arsenal007/ADX/PCB/LCSDR.ods

Sheet: Sheet1
Id | Designator | Package | Quantity | Designation | Supplier and ref
1 | C82,C14,C20,C72,C74,C76,C78,C80,C84,C2,C3,C6,C16,C18,C22,C24,C26,C38,C45,C47,C50,C53,C55,C61,C73,C134,C89,C91,C108,C116,C117,C123,C124,C129,C130,C132,C104,C115,C125,C131,C92,C133 | C_1206_0603 | 42 | 100n
2 | R4,R1 | R_1206_0603 | 2 | k75
3 | U8,U1 | SOIC-14_3.9x8.7mm_Pitch1.27mm | 2 | MC33179DR2G
4 | C60,C69 | C_0603 | 2 | 390p
5 | L13,L12 | Resistor_Horizontal_RM10mm | 2 | 472K
6 | C57,C58,C63,C66,C68,C70,C8,C9 | TantalC_SizeA_EIA-3216_Wave | 8 | 6.8uF
7 | C10,C5,L17,L19 | C_0603 | 4 | 4.7uF
8 | C11,C34,C56,C65 | C_0603 | 4 | 15n
9 | C21,C86,C87,L23,L24,L25 | C_1206_0603 | 6 | 1uF
10 | C23,C33,C43,C51 | C_1206_0603 | 4 | 27n
11 | C25 | C_1206_0603 | 1 | 22p
12 | C44 | C_1206_0603 | 1 | 2n2
13 | C71,C90,C95,C96,C98,C99 | C_1206_0603 | 6 | 1n
14 | C77,C85,C83 | C_Radial_D5_L11_P2.5 | 3 | 100uF
15 | L11,L3,L2,L5 | Resistor_Horizontal_RM10mm | 4 | 100uH
16 | R3,R44,R9,R14,R22,R41,R52,R59,R60,R61,R62,R63,R64 | R_1206_0603 | 13 | 10k
17 | R5,R13,R25,R34,R40,R42,R43,R46,R47,R48 | R_0603 | 10 | 4k75
18 | R8,R29,R7,R26,R39,R45 | R_0603 | 6 | 1k 1%
19 | R11,R21,R31,R2 | R_0603 | 4 | 3k 1%
20 | R15,R16 | R_1206_0603 | 2 | k51
21 | R17,R36,R24,R33 | R_1206_0603 | 4 | 20R
22 | R19,R20,R53,R54 | R_1206_0603 | 4 | 2k2
23 | R28 | R_0603 | 1 | k560
24 | R30,R10 | R_0603 | 2 | k27
25 | R32,R18 | R_0603 | 2 | 1k5
26 | R37,R38,R49,R51 | R_1206_0603 | 4 | 1k
27 | R50 | R_1206_0603 | 1 | k15
28 | U2,U9,U3,U6 | TSSOP-16_4.4x5mm_Pitch0.65mm | 4 | 74HC4053
29 | U13 | SOT-223 | 1 | LD1117S33TR
30 | U14 | SOT-223 | 1 | LD1117S25CTR
31 | U4,U5 | SOT-23-6 | 2 | SN74LVC1G3157
32 | U11 | Si570 | 1 | Si570
33 | C19,C30,C41,C48,C13 | TantalC_SizeA_EIA-3216_Wave | 5 | 10uF 16v
34 | J1,J2,J3,J4 | audio_jack_3_5mm_PJ307 | 4 | JACK_TRS_3pins
35 | C27,C28 | C_0603 | 2 | 15pF
36 | C31,C32 | C_1206_0603 | 2 | 3n3
37 | C35,C37 | C_0603 | 2 | 120pF
38 | C36 | C_1206_0603 | 1 | 220pF
39 | C40 | C_1206_0603 | 1 | 22n
40 | C42 | C_0603 | 1 | 220p
41 | C59,C64 | C_1206_0603 | 2 | 10n
42 | L6,L7,L8 | C_0603 | 3 | 4,7uH
43 | Q1 | SOT-23 | 1 | BC850
44 | R6,R12 | R_1206_0603 | 2 | k10
45 | R23 | R_1206_0603 | 1 | 1M5
46 | R27 | R_0603 | 1 | k43
47 | R55 | R_1206_0603 | 1 | k18
48 | U7 | DHVQFN14 | 1 | 74LVC74ABQ
49 | U10 | XQFN8 | 1 | 74LVC1G74GM
50 | CON1 | BARREL_JACK | 1 | BARREL_JACK
51 | R35 | R_1206_0603 | 1 | 27R
52 | U16 | SO-16-W | 1 | PCF8574
53 | L1,L4,L9,L10 | Resistor_Horizontal_RM10mm | 4 | 47uH
54 | U12 | TO-252-2Lead | 1 | L78M09
55 | P8 | Pin_Header_Straight_1x03 | 1 | TX_PA
56 | C94 | C_0603 | 1 | 200p
57 | C97 | C_0603 | 1 | 750p
58 | C100 | C_0603 | 1 | 750pF
59 | C101,C102,C109,C110 | C_0603 | 4 | 220n
60 | C103,C105,C107 | C_0603 | 3 | 680p
61 | C106,C112,C113,C67 | C_0603 | 4 | 820p
62 | C111,C120,C122 | C_0603 | 3 | 360p
63 | C114,C119,C121 | C_1206_0603 | 3 | 33p
64 | C118 | C_1206_0603 | 1 | 180p
65 | C126 | C_0603 | 1 | 120p
66 | C127,C128 | C_1206_0603 | 2 | 270p
67 | D1,D2,D3,D4,D5,D6,D7,D8,D9,D10 | MiniMELF_Standard | 10 | BAV203-G08
68 | L16 | C_0603 | 1 | 10uF
69 | L18 | C_0603 | 1 | 4.7uH
70 | L20,L21,L22 | C_1206_0603 | 3 | 2.2uF
71 | L26,L27,L28 | C_0603 | 3 | 470nF
72 | L29,L30 | C_0603 | 2 | 220nF
73 | P2 | Pin_Header_Straight_1x03 | 1 | ANT/PA
74 | R56,R57 | R_1206_0603 | 2 | k47
75 | U15 | TO-92_Inline_Narrow_Oval | 1 | 78L05
76 | U17 | SOIC-16_3.9x9.9mm_Pitch1.27mm | 1 | ULN2003_
77 | L14,L15 | Resistor_Horizontal_RM10mm | 2 | 47uF
78 | R58 | R_1206_0603 | 1 | 0*
79 | P1 | Pin_Header_Straight_1x04 | 1 | I2C_Si570
80 | U18 | XQFN8 | 1 | PCA9306
81 | P3,P4,P5 | Pin_Header_Straight_1x02 | 3 | CONN_01X02
82 | C75 | C_Radial_D10_L13_P5 | 1 | 820uF
83 | O1,O2,O3,O4 | MountingHole_3.2mm_M3_Pad_Via | 4 | Mount_Hole
84 | C12,C29,C39,C62 | TantalC_SizeA_EIA-3216_Wave | 4 | 10uF
85 | C49,C52,C54,C88,C93,C7,C17,C79,C81,C4,C15,C1 | Universal_C_Radial_D5_L11_P2_tantal | 12 | 10uF
86 | C46 | Universal_C_Radial_D5_L11_P2_tantal | 1 | 10uF

Sheet: Assembly
Stage1
 | C74 | 1206 | 100n
 | CON1 | 2.1mm
 | C75 | 5mm(TH) D10 | 820uF
 | U12 | D2PAK | L78M09
 | C76 | 1206 | 100n
 | C77 | 2,5mm(TH) D10 | 100uF
 | C78 | 1206 | 100n
 | C79 |  | 10uF
 | C80 | 1206 | 100n
 | C81 |  | 10uF
 | U13 | 223 | LD1117S33TR
 | C82 | 1206 | 100n
 | C83 | 2,5mm(TH) D10 | 100uF
 | U14 | 223 | LD1117S25TR
 | R55 | 1206 | k180
 | C84 | 1206 | 100n
 | U15 | TO-92 | 78L05
 | C85 | 2,5mm(TH) D10 | 100uF
 | C88 | 2mm (TH) D10 | 10uF
 | C91 | 1206 | 100n
 | C92 | 1206 | 100n
 | C93 | 2mm (TH) D10 | 10uF
Check voltages output on U12/U13/U14
Stage2(Schifting voltages and Inductors)
 | R15 | 1206 | k51
 | R16 | 1206 | k51
 | C13 | Tantal. SizeA | 10uf
 | C14 | 1206 | 100n
 | L4 | 10mm TH | 47uH
 | C21 | 1206 | 100n
 | C22 | 1206 | 1uF
 | L9 | 10mm TH | 47uH
 | C45 | 1206 | 100n
 | C47 | 1206 | 100n
 | C46 | 2mm (TH) D10 | 10uF
 | R49 | 1206 | 1k
 | R51 | 1206 | 1k
 | R50 | 1206 | k15
 | C72 | 1206 | 100n
 | C71 | 1206 | 1n
 | C73 | 1206 | 100n
 | L3 | 10mm TH | 100uH
 | C15 | 2mm (TH) D10 | 10uF
 | C17 | 2mm (TH) D10 | 10uF
 | C16 | 1206 | 100n
 | C18 | 1206 | 100n
 | C134 | 1206 | 100n
 | L1 | 10mm TH | 47uH
 | C3 | 1206 | 100n
 | C4 | 2mm (TH) D10 | 10uF
 | L10 | 10mm TH | 47uH
 | C52 | 2,5mm(TH) D10 | 10uF
 | C53 | 1206 | 100n
 | C62 | Tantal. SizeA | 10uF
 | C63 | 1206 | 100n
 | R1 | 1206 | k750
 | R4 | 1206 | k750
 | C7 | 2mm (TH) D10 | 10uF
 | C6 | 1206 | 100n
 | L11 | 10mm TH | 100uH
 | L2 | 10mm TH | 100uH
 | C1 | 2mm (TH) D10 | 10uF
 | C2 | 1206 | 100n
 | C54 | 2mm (TH) D10 | 10uF
 | C55 | 1206 | 100n
 | R27 | 0603 | k43
 | R28 | 0603 | k56
 | C38 | 1206 | 100n
 | C39 | 2mm (TH) D10 | 1206
 | R37 | 1206 | 1k
 | R38 | 1206 | 1k
 | C49 | 2mm (TH) D10 | 10uF
 | C50 | 1206 | 100n
 | C12 | 2mm (TH) D10 | 10uF
 | C20 | 1206 | 100n
 | C133 | 1206 | 100n
 | L14 | 10mm TH | 47uH
 | L15 | 10mm TH | 47uH
 | R56 | 1206 | k47
 | R57 | 1206 | k47
 | D1 |  | BAV203-g08
 | D2 |  | BAV203-g08
 | L17 | 0603 | 4.7uH
 | L18 | 0603 | 4.7uH
 | C101 | 0603 | 220n
 | C102 | 0603 | 220n
 | R59 | 1206 | 10k
 | D3 |  | BAV203-g08
 | D4 |  | BAV203-g08
 | L21 | 1206 | 2.2uH
 | L20 | 1206 | 2.2uH
 | R60 | 1206 | 10k
 | С110 | 0603 | 220n
 | C109 | 0603 | 220n
 | D5 |  | BAV203-g08
 | D6 |  | BAV203-g08
 | L23 | 1206 | 1uH
 | L24 | 1206 | 1uH
 | R61 | 1206 | 10k
 | C116 | 1206 | 100n
 | C117 | 1206 | 100n
 | D7 |  | BAV203-g08
 | D8 |  | BAV203-g08
 | L26 | 0603 | 470nH
 | L27 | 0603 | 470nH
 | C123 | 1206 | 100n
 | C124 | 1206 | 100n
 | R62 | 1206 | 10k
 | D9 |  | BAV203-g08
 | D10 |  | BAV203-g08
 | C129 | 1206 | 100n
 | C130 | 1206 | 100n
 | L29 | 0603 | 220nH
 | L30 | 0603 | 220nH
 | R63 | 1206 | 10k
 | C89 | 1206 | 100n
 | C108 | 1206 | 100n
 | C115 | 1206 | 100n
 | C125 | 1206 | 100n
 | C131 | 1206 | 100n
Test all voltages on U4/U5/U3/U6/U1/U8/U10/U7/U11/U16/U18/U9/U2/R27_R28(MIC_AMP)/R37_R38(LIN input schift)/R1_R4(OA_AMP_BASIS)/R49_R51_Si570_schift
Stage3 (digital testing) | U11 |  | Si570
 | U16 |  | PCF8574
 | U18 |  | PCA9306
 | R64 | 1206 | 10k
 | R52 | 1206 | 10k
 | R53 | 1206 | 2k2
 | R54 | 1206 | 2k2
 | U17 | SO-16 | ULN2003
 | C65 | 0603 | 15n
 | C11 | 0603 | 15n
