arsenal007/ADX/PCBs_OpA/LCSDR.kicad_pcb

## KiCad design PCBs_OpA/LCSDR.kicad_pcb (2023-01-05)

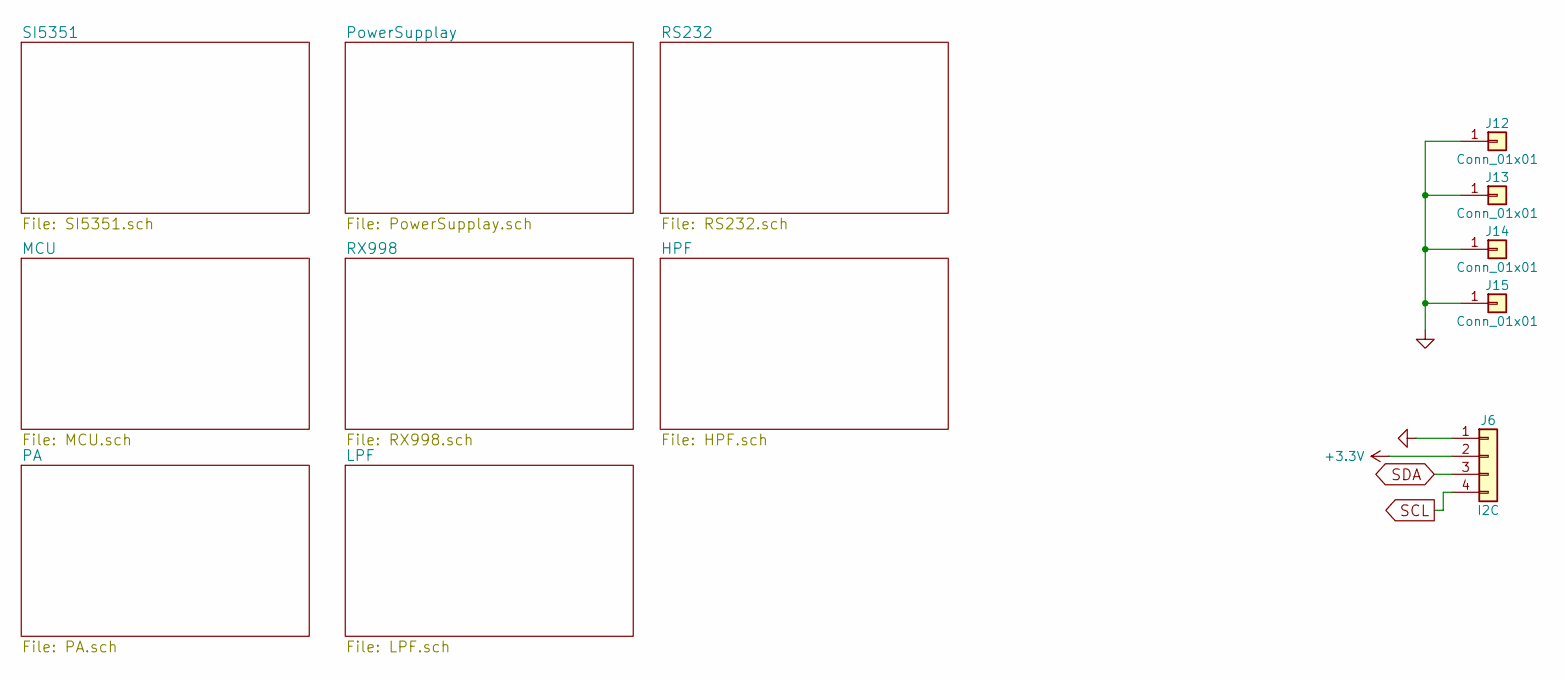
[picture p1: schematic LCSDR.sch, ADX988]

Parts:
J6: I2C; Pin_Header_Straight_1x04_Pitch2.54mm
J12, J13, J14, J15: Conn_01x01; MountingHole_3.2mm_M3_DIN965_Pad

Connections:
+3V3: J6.2; also elsewhere on the board
GND: J6.1, J12.1, J13.1, J14.1, J15.1; also elsewhere on the board
SCL: J6.4; also elsewhere on the board
SDA: J6.3; also elsewhere on the board

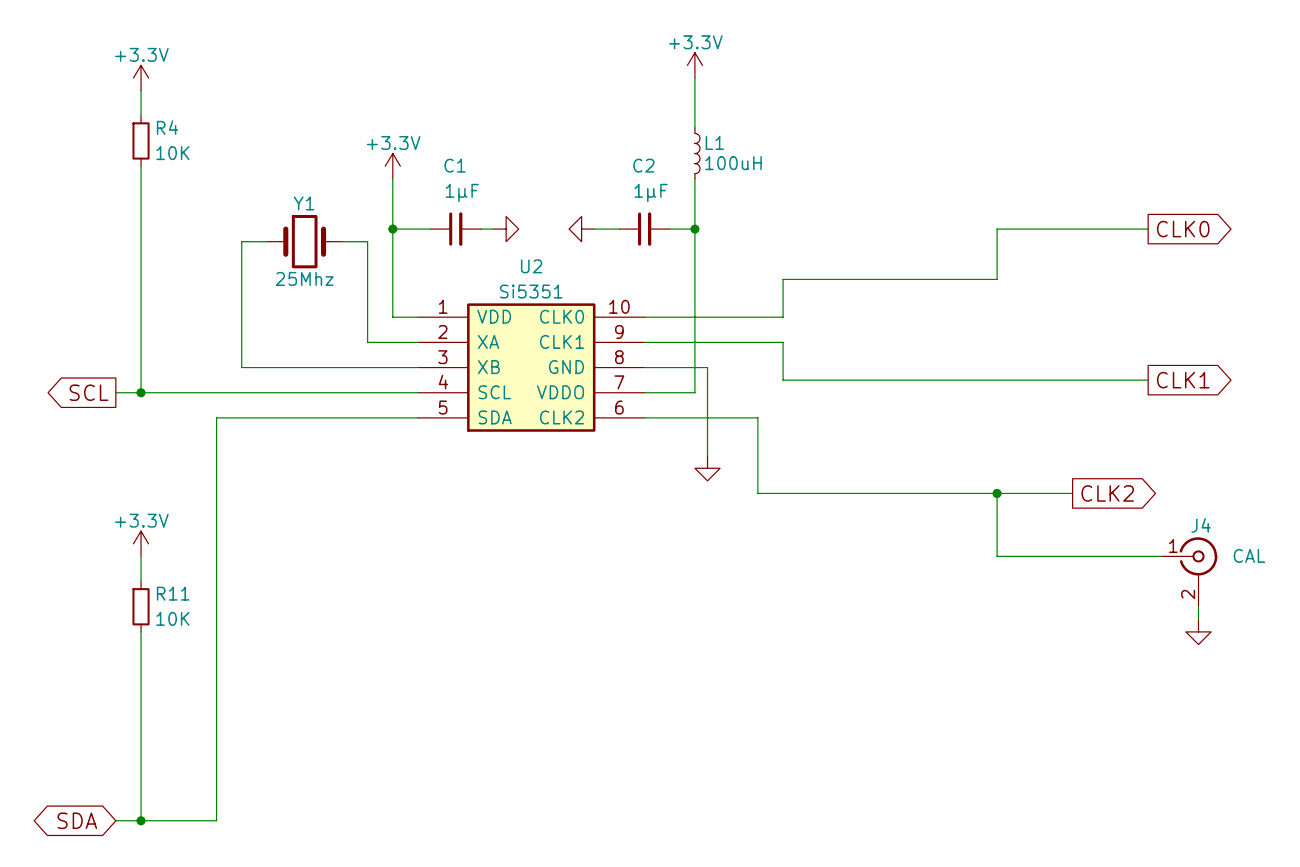
[picture p2: schematic SI5351.sch]

Parts:
C1, C2: 1µF; C_1206_0603
J4: CAL; U.FL_Molex_MCRF_73412-0110_Vertical
L1: 100uH; R_Axial_DIN0207_L6.3mm_D2.5mm_P10.16mm_Horizontal
R4, R11: 10K; R_1206_0603
U2: Si5351; MSOP-10_3x3mm_Pitch0.5mm
Y1: 25Mhz; Crystal_SMD_HC49-SD

Connections:
+3V3: C1.1, L1.1, R4.1, R11.1, U2.1 (VDD); also elsewhere on the board
CLK0: U2.10 (CLK0); also elsewhere on the board
CLK1: U2.9 (CLK1); also elsewhere on the board
CLK2: J4.1 (In), U2.6 (CLK2); also elsewhere on the board
GND: C1.2, C2.1, J4.2 (Ext), U2.8 (GND); also elsewhere on the board
unnamed: C2.2, L1.2, U2.7 (VDDO)
unnamed: U2.2 (XA), Y1.2
unnamed: U2.3 (XB), Y1.1
SCL: R4.2, U2.4 (SCL); also elsewhere on the board
SDA: R11.2, U2.5 (SDA); also elsewhere on the board

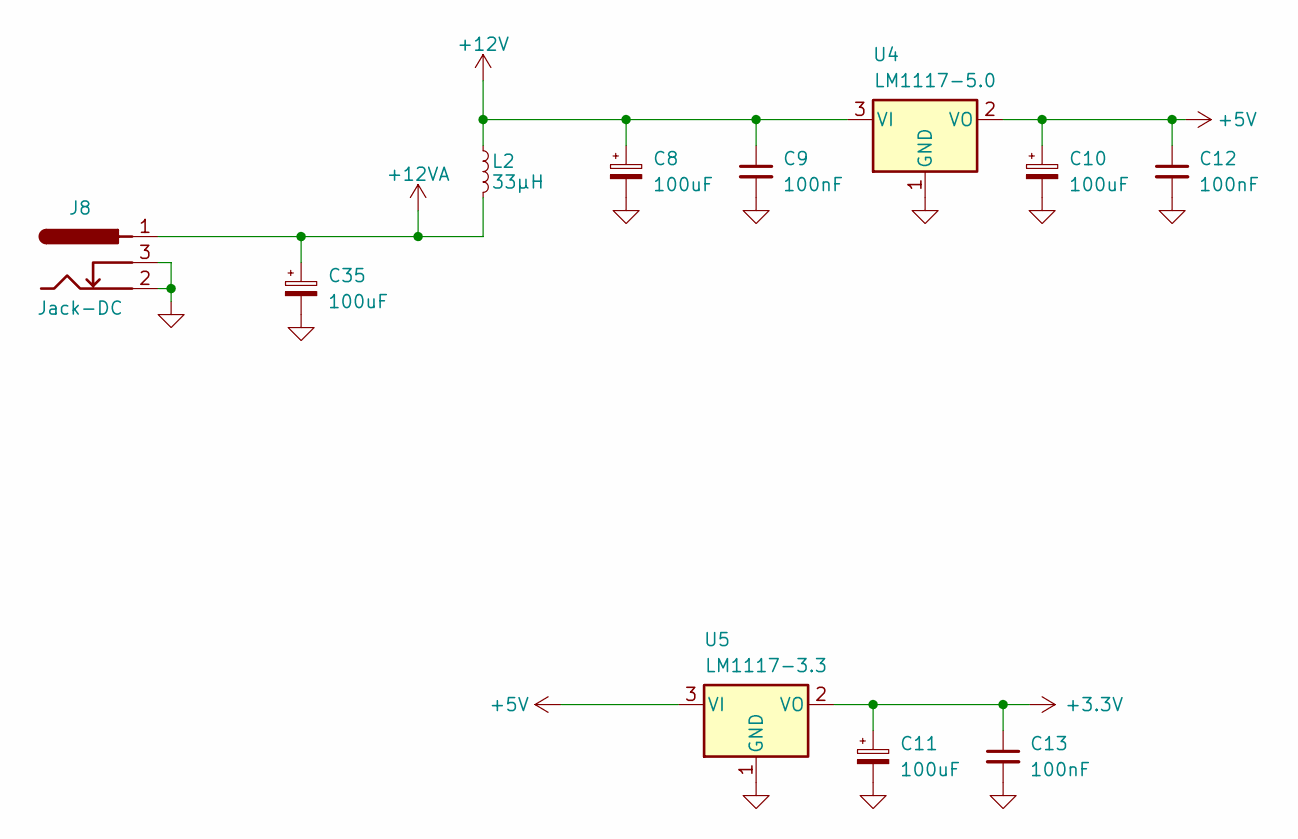
[picture p3: schematic PowerSupplay.sch]

Parts:
C8, C10, C11, C35: 100uF; CP_Radial_D6.3mm_P2.50mm
C9, C12, C13: 100nF; C_1206_0603
J8: Jack-DC; BARREL_JACK
L2: 33µH; Choke_Horizontal_RM10mm
U4: LM1117-5.0; SOT-223-3_TabPin2
U5: LM1117-3.3; SOT-223-3_TabPin2

Connections:
+3V3: C11.1, C13.1, U5.2 (VO); also elsewhere on the board
+5V: C10.1, C12.1, U4.2 (VO), U5.3 (VI); also elsewhere on the board
+12V: C8.1, C9.1, L2.1, U4.3 (VI); also elsewhere on the board
+12VA: C35.1, J8.1, L2.2; also elsewhere on the board
GND: C8.2, C9.2, C10.2, C11.2, C12.2, C13.2, C35.2, J8.2, J8.3, U4.1 (GND), U5.1 (GND); also elsewhere on the board

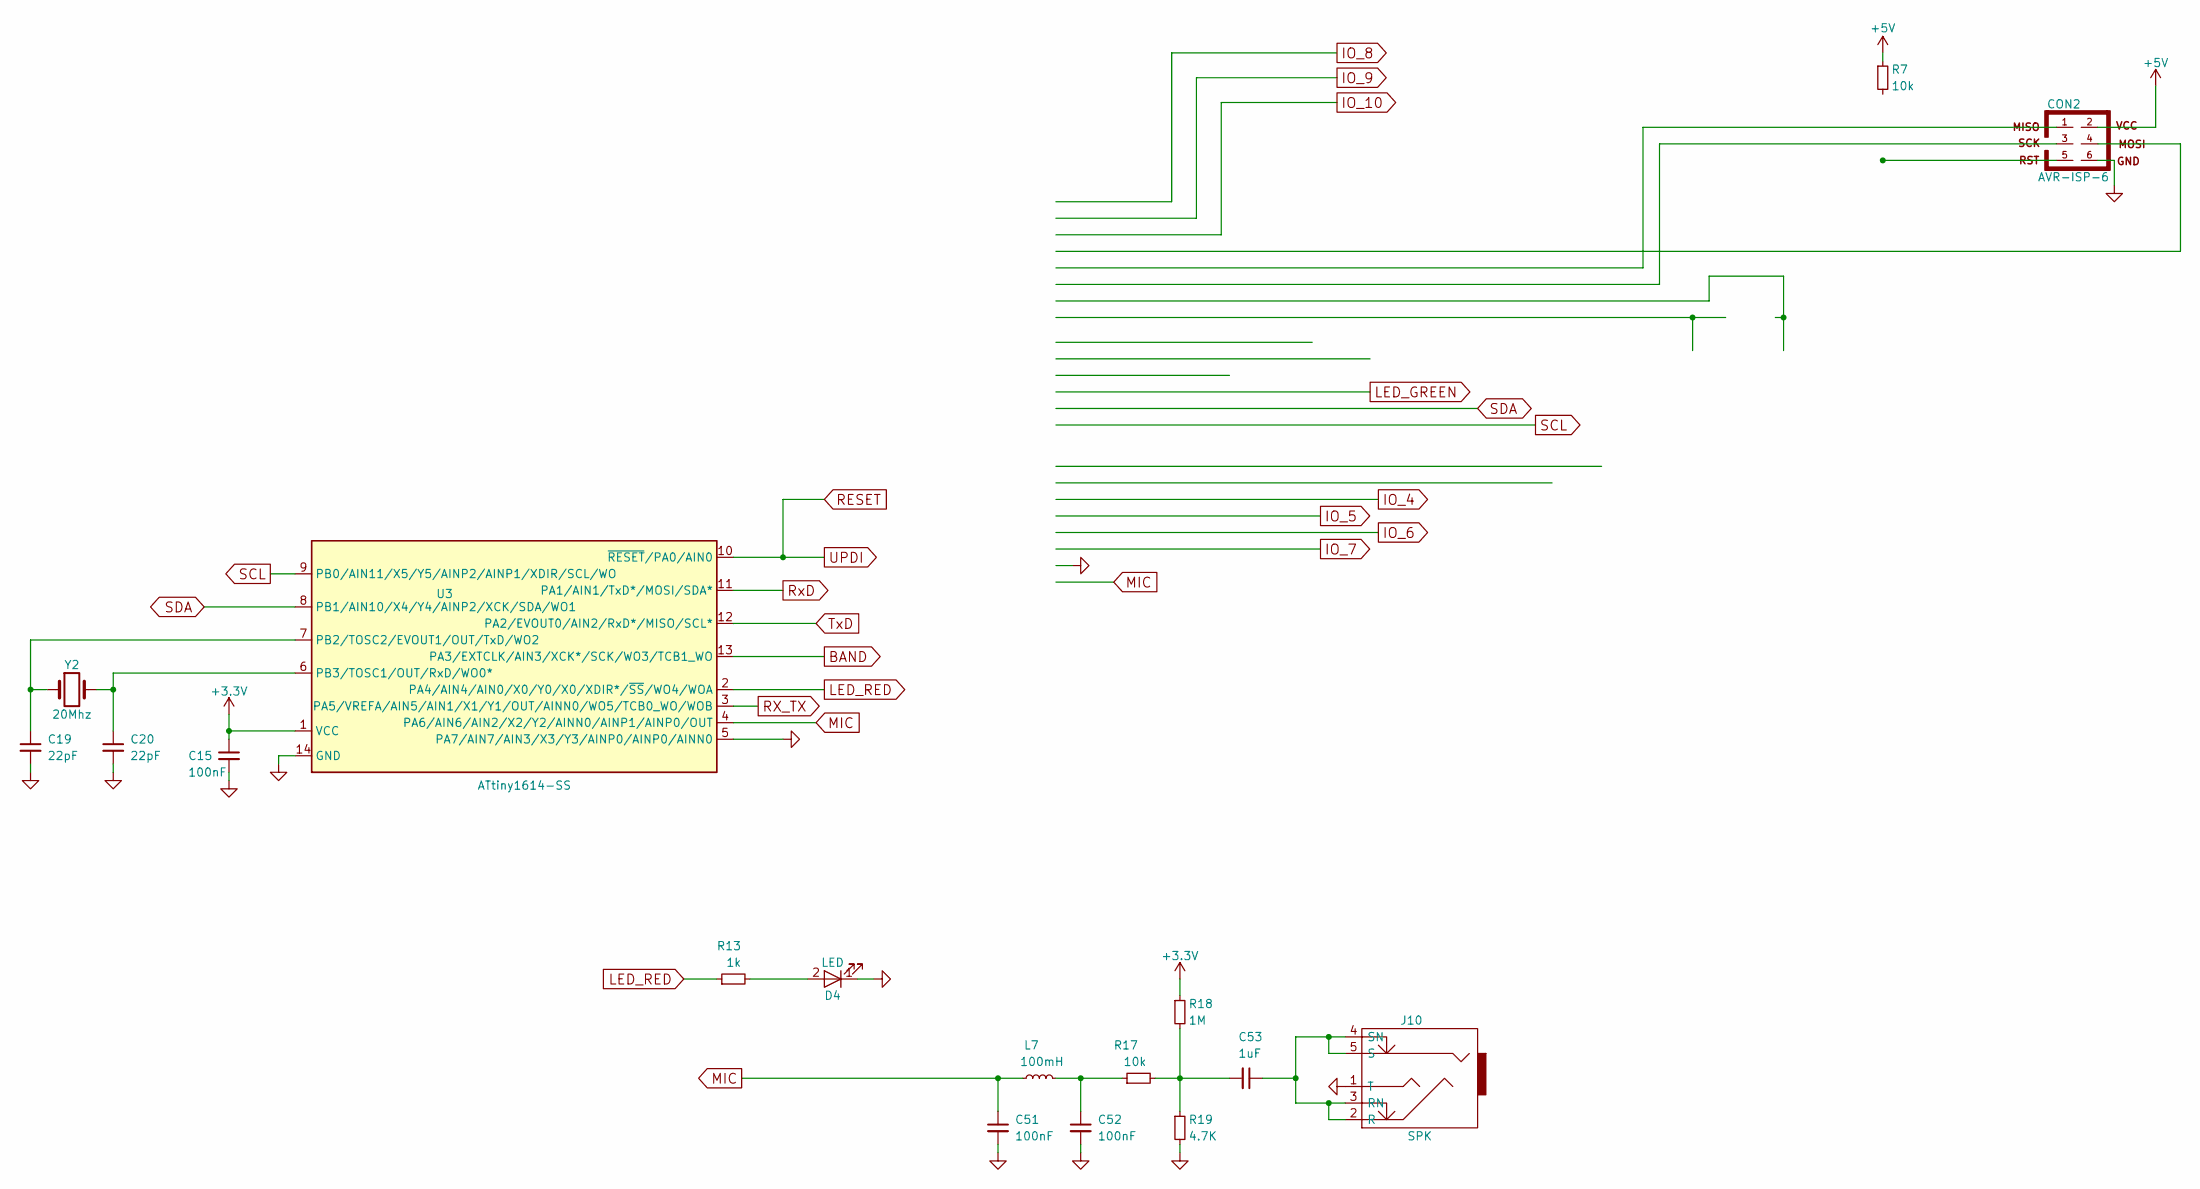
[picture p4: schematic MCU.sch]

Parts:
C15, C51, C52: 100nF; C_1206_0603
C19, C20: 22pF; C_1206_0603
C53: 1uF; C_1206_0603
CON2: AVR-ISP-6; IDC-Header_2x03_Pitch2.54mm_Straight
D4: LED; LED_D3.0mm_Horizontal_O3.81mm_Z10.0mm
J10: SPK; audio_jack_3_5mm_PJ307
L7: 100mH; Choke_Toroid_8x16mm_Vertical
R7, R17: 10k; R_1206_0603
R13: 1k; R_1206_0603
R18: 1M; R_1206_0603
R19: 4.7K; R_1206_0603
U3: ATtiny1614-SS; SOIC-14_3.9x8.7mm_Pitch1.27mm
Y2: 20Mhz; Crystal_HC49-U_Vertical

Connections:
+3V3: C15.1, R18.1, U3.1 (VCC); also elsewhere on the board
+5V: CON2.2, R7.1; also elsewhere on the board
GND: C15.2, C19.2, C20.2, C51.2, C52.2, CON2.6, D4.1 (K), J10.1 (T), R19.2, U3.5 (PA7/AIN7/AIN3/X3/Y3/AINP0/AINP0/AINN0), U3.14 (GND); also elsewhere on the board
LED_RED: R13.1, U3.2 (PA4/AIN4/AIN0/X0/Y0/X0/XDIR*/~SS~/WO4/W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)
MIC: C51.1, L7.1, U3.4 (PA6/AIN6/AIN2/X2/Y2/AINN0/AINP1/AINP0/O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)
unnamed: C19.1, U3.7 (PB2/TOSC2/EVOUT1/OUT/TxD/WO2), Y2.1
unnamed: C20.1, U3.6 (PB3/TOSC1/OUT/RxD/WO0*), Y2.2
unnamed: C52.1, L7.2, R17.1
unnamed: C53.1, J10.2 (R), J10.3 (RN), J10.4 (SN), J10.5 (S)
unnamed: C53.2, R17.2, R18.2, R19.1
unnamed: D4.2 (A), R13.2
RESET: U3.10 (~RESET~/PA0/AIN0); also elsewhere on the board
RX_TX: U3.3 (PA5/VREFA/AIN5/AIN1/X1/Y1/OUT/AINN0/WO5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); also elsewhere on the board
RxD: U3.11 (PA1/AIN1/TxD*/MOSI/SDA*); also elsewhere on the board
SCL: U3.9 (PB0/AIN11/X5/Y5/AINP2/AINP1/XDIR/SCL/WO); also elsewhere on the board
SDA: U3.8 (PB1/AIN10/X4/Y4/AINP2/XCK/SDA/WO1); also elsewhere on the board
TxD: U3.12 (PA2/EVOUT0/AIN2/RxD*/MISO/SCL*); also elsewhere on the board

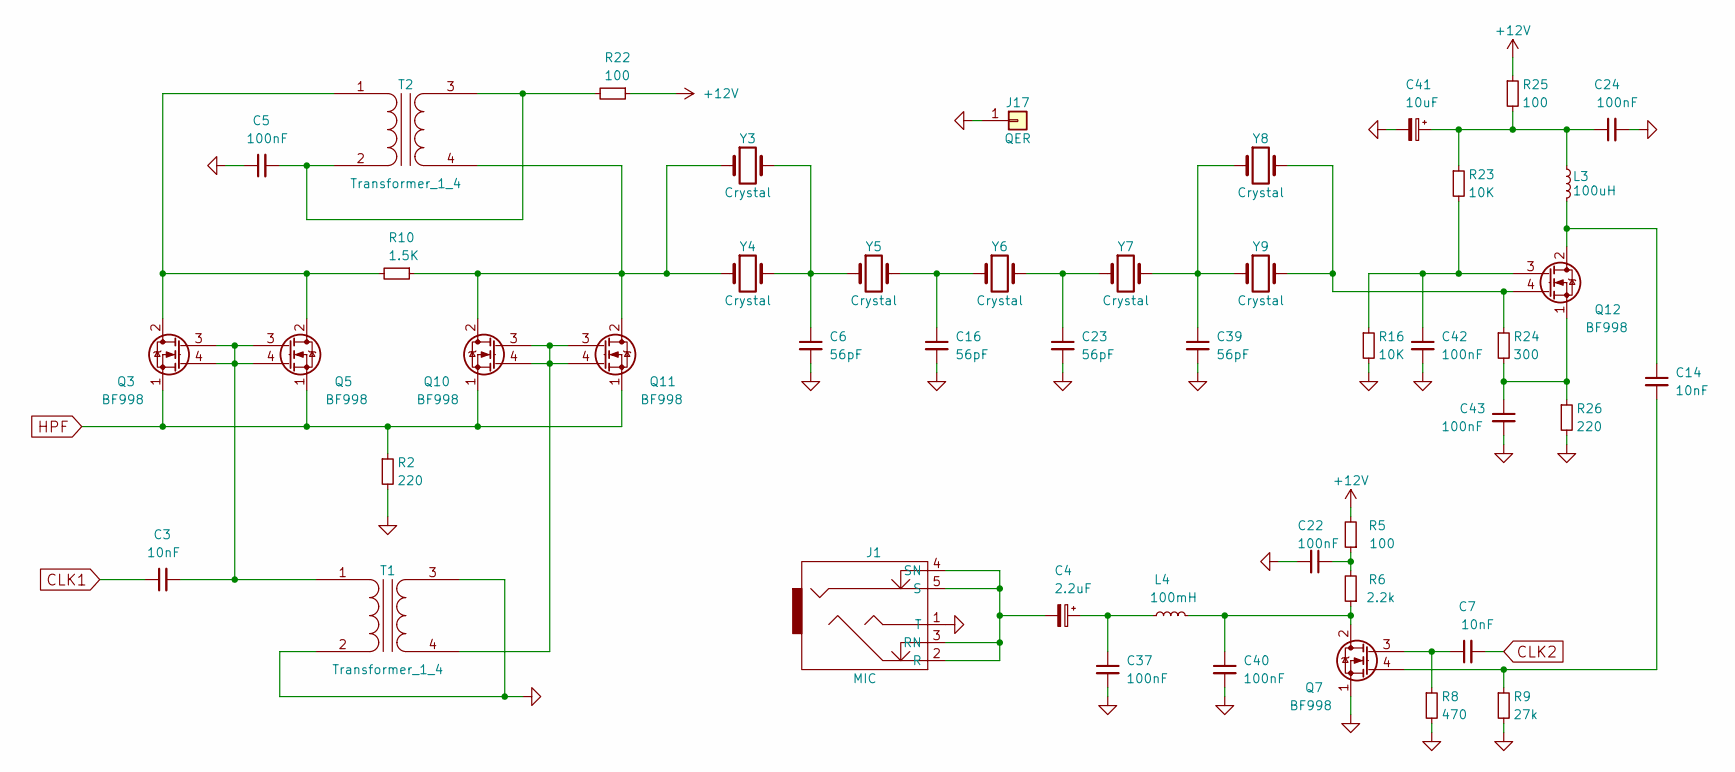
[picture p5: schematic RX998.sch]

Parts:
C3, C7, C14: 10nF; C_1206_0603
C4: 2.2uF; CP_Radial_D5.0mm_P2.00mm
C5, C22, C24, C37, C40, C42, C43: 100nF; C_1206_0603
C6, C16, C23, C39: 56pF; C_1206_0603
C41: 10uF; CP_Radial_D5.0mm_P2.00mm
J1: MIC; audio_jack_3_5mm_PJ307
J17: QER; Pin_Header_Straight_1x01_Pitch2.54mm
L3: 100uH; Choke_Horizontal_RM10mm
L4: 100mH; Choke_Toroid_8x16mm_Vertical
Q3, Q5, Q7, Q10, Q11, Q12: BF998; SOT-143
R2, R26: 220; R_1206_0603
R5, R22, R25: 100; R_1206_0603
R6: 2.2k; R_1206_0603
R8: 470; R_1206_0603
R9: 27k; R_1206_0603
R10: 1.5K; R_1206_0603
R16, R23: 10K; R_1206_0603
R24: 300; R_1206_0603
T1, T2: Transformer_1_4; TF14
Y3, Y4, Y5, Y6, Y7, Y8, Y9: Crystal; Crystal_HC49-U_Vertical

Connections:
+12V: R5.2, R22.1, R25.1; also elsewhere on the board
CLK1: C3.1; also elsewhere on the board
CLK2: C7.2; also elsewhere on the board
GND: C5.1, C6.2, C16.2, C22.2, C23.2, C24.2, C37.2, C39.2, C40.2, C41.2, C42.2, C43.2, J1.1 (T), J17.1, Q7.1 (S), R2.2, R8.2, R9.2, R16.2, R26.2, T1.2 (AB), T1.3; also elsewhere on the board
HPF: Q3.1 (S), Q5.1 (S), Q10.1 (S), Q11.1 (S), R2.1; also elsewhere on the board
unnamed: C3.2, Q3.3 (G2), Q3.4 (G1), Q5.3 (G2), Q5.4 (G1), T1.1 (AA)
unnamed: C4.2, J1.2 (R), J1.3 (RN), J1.4 (SN), J1.5 (S)
unnamed: C5.2, R22.2, T2.2 (AB), T2.3
unnamed: C6.1, Y3.2, Y4.2, Y5.1
unnamed: C7.1, Q7.3 (G2), R8.1
unnamed: C14.1, L3.2, Q12.2 (D)
unnamed: C14.2, Q7.4 (G1), R9.1
unnamed: C16.1, Y5.2, Y6.1
unnamed: C22.1, R5.1, R6.2
unnamed: C23.1, Y6.2, Y7.1
unnamed: C24.1, C41.1, L3.1, R23.1, R25.2
unnamed: C4.1, C37.1, L4.1
unnamed: C39.1, Y7.2, Y8.1, Y9.1
unnamed: C40.1, L4.2, Q7.2 (D), R6.1
unnamed: C42.1, Q12.3 (G2), R16.1, R23.2
unnamed: C43.1, Q12.1 (S), R24.2, R26.1
unnamed: Q3.2 (D), Q5.2 (D), R10.2, T2.1 (AA)
unnamed: Q10.2 (D), Q11.2 (D), R10.1, T2.4, Y3.1, Y4.1
unnamed: Q10.3 (G2), Q10.4 (G1), Q11.3 (G2), Q11.4 (G1), T1.4
unnamed: Q12.4 (G1), R24.1, Y8.2, Y9.2

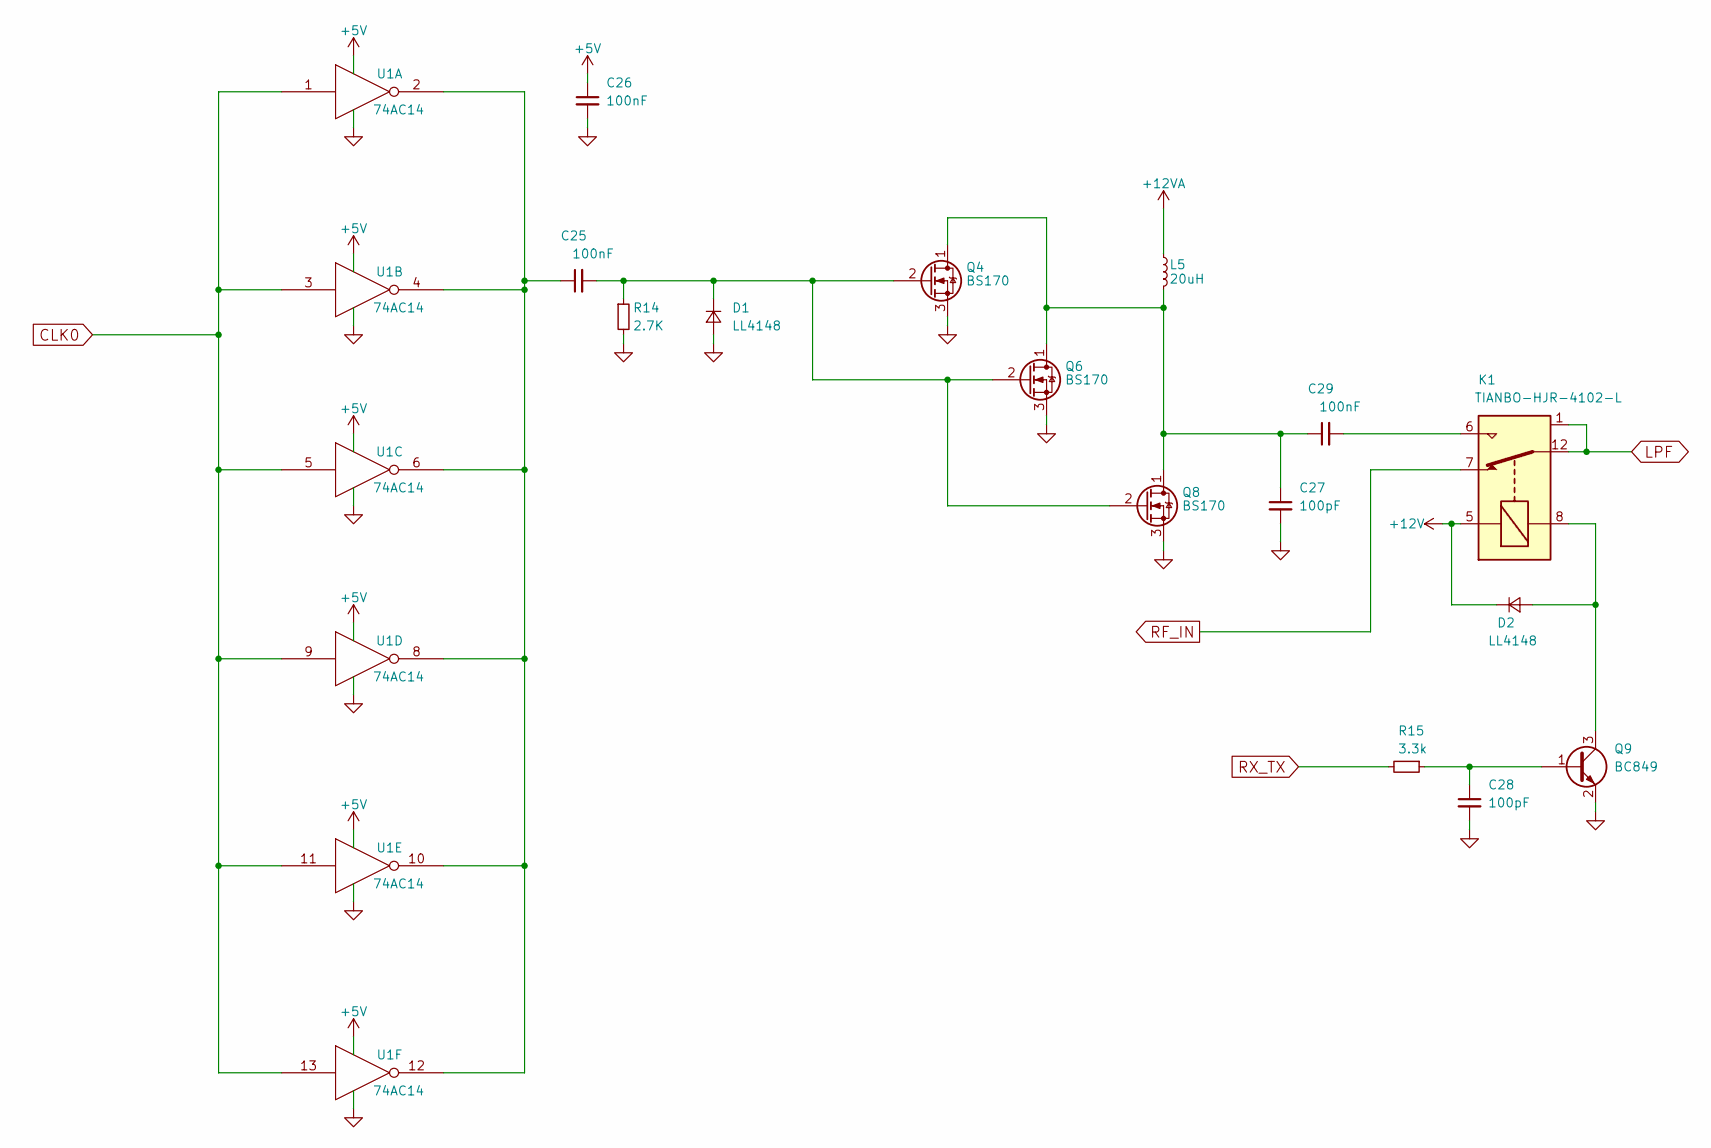
[picture p6: schematic PA.sch]

Parts:
C25, C26, C29: 100nF; C_1206_0603
C27: 100pF; C_Disc_D4.7mm_W2.5mm_P5.00mm
C28: 100pF; C_1206_0603
D1, D2: LL4148; D_MiniMELF
K1: TIANBO-HJR-4102-L; Relay_SPDT_HJR-4102
L5: 20uH; Choke_Toroid_6,5x13mm_Vertical
Q4, Q6, Q8: BS170; TO-92_Inline_Wide
Q9: BC849; SOT-23
R14: 2.7K; R_1206_0603
R15: 3.3k; R_1206_0603
U1: 74AC14; DIP-14_W7.62mm_LongPads

Connections:
+5V: C26.1, U1.14 (VCC); also elsewhere on the board
+12V: D2.1 (K), K1.5; also elsewhere on the board
+12VA: L5.1; also elsewhere on the board
CLK0: U1.1, U1.3, U1.5, U1.9, U1.11, U1.13; also elsewhere on the board
GND: C26.2, C27.2, C28.2, D1.2 (A), Q4.3 (S), Q6.3 (S), Q8.3 (S), Q9.2 (E), R14.2, U1.7 (GND); also elsewhere on the board
LPF: K1.1, K1.12; also elsewhere on the board
unnamed: C25.1, U1.2, U1.4, U1.6, U1.8, U1.10, U1.12
unnamed: C25.2, D1.1 (K), Q4.2 (G), Q6.2 (G), Q8.2 (G), R14.1
unnamed: C27.1, C29.1, L5.2, Q4.1 (D), Q6.1 (D), Q8.1 (D)
unnamed: C28.1, Q9.1 (B), R15.1
unnamed: C29.2, K1.6
unnamed: D2.2 (A), K1.8, Q9.3 (C)
RF_IN: K1.7; also elsewhere on the board
RX_TX: R15.2; also elsewhere on the board

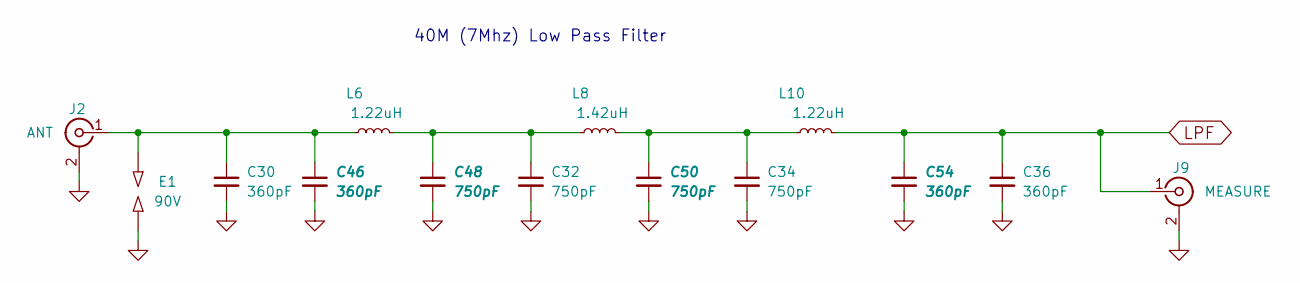
[picture p7: schematic LPF.sch]

Parts:
C30, C36: 360pF; C_Disc_D4.7mm_W2.5mm_P5.00mm
C32, C34: 750pF; C_Disc_D4.7mm_W2.5mm_P5.00mm
C46, C54: 360pF; C_1206_0603
C48, C50: 750pF; C_1206_0603
E1: 90V; C_Rect_L11.0mm_W8.8mm_P10.00mm_MKT
J2: ANT; SMA_THT_Jack_Straight
J9: MEASURE; U.FL_Molex_MCRF_73412-0110_Vertical
L6, L10: 1.22uH; Choke_Toroid_6,5x13mm_Vertical
L8: 1.42uH; Choke_Toroid_6,5x13mm_Vertical

Connections:
GND: C30.2, C32.2, C34.2, C36.2, C46.2, C48.2, C50.2, C54.2, E1.2, J2.2 (Ext), J9.2 (Ext); also elsewhere on the board
LPF: C36.1, C54.1, J9.1 (In), L10.2; also elsewhere on the board
unnamed: C30.1, C46.1, E1.1, J2.1 (In), L6.1
unnamed: C32.1, C48.1, L6.2, L8.1
unnamed: C34.1, C50.1, L8.2, L10.1

Notes on the sheet:
40M (7Mhz) Low Pass Filter

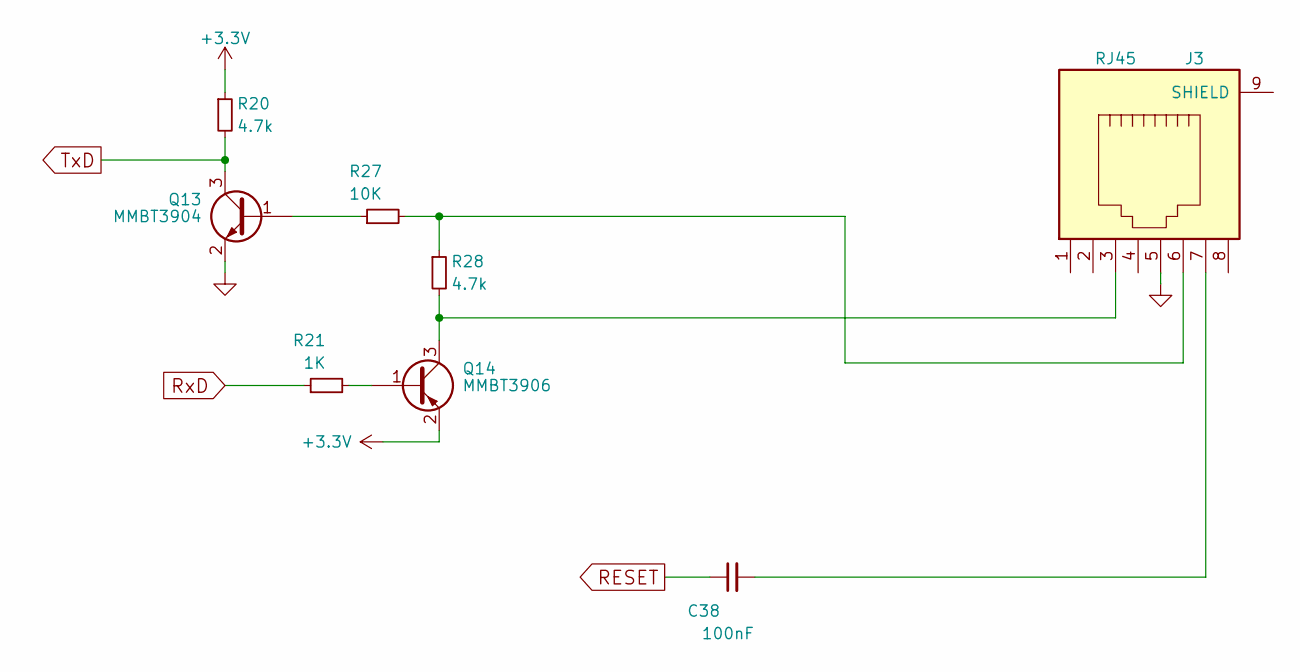
[picture p8: schematic RS232.sch]

Parts:
C38: 100nF; C_1206_0603
J3: RJ45; RJ45_8
Q13: MMBT3904; SOT-23
Q14: MMBT3906; SOT-23
R20, R28: 4.7k; R_0603_HandSoldering
R21: 1K; R_0603_HandSoldering
R27: 10K; R_0603_HandSoldering

Connections:
+3V3: Q14.2 (E), R20.1; also elsewhere on the board
GND: J3.5, Q13.2 (E); also elsewhere on the board
unnamed: C38.2, J3.7
unnamed: J3.3, Q14.3 (C), R28.2
unnamed: J3.6, R27.2, R28.1
unnamed: Q13.1 (B), R27.1
unnamed: Q14.1 (B), R21.2
RESET: C38.1; also elsewhere on the board
RxD: R21.1; also elsewhere on the board
TxD: Q13.3 (C), R20.2; also elsewhere on the board

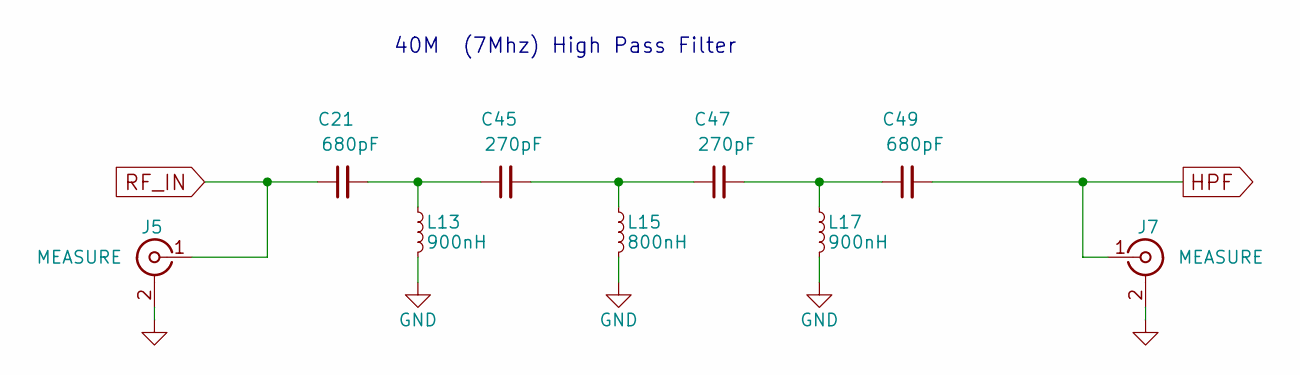
[picture p9: schematic HPF.sch]

Parts:
C21, C49: 680pF; C_1206_0603
C45, C47: 270pF; C_1206_0603
J5, J7: MEASURE; U.FL_Molex_MCRF_73412-0110_Vertical
L13, L17: 900nH; Choke_Toroid_6,5x13mm_Vertical
L15: 800nH; Choke_Toroid_6,5x13mm_Vertical

Connections:
GND: J5.2 (Ext), J7.2 (Ext), L13.2, L15.2, L17.2; also elsewhere on the board
HPF: C49.2, J7.1 (In); also elsewhere on the board
unnamed: C21.2, C45.1, L13.1
unnamed: C45.2, C47.1, L15.1
unnamed: C47.2, C49.1, L17.1
RF_IN: C21.1, J5.1 (In); also elsewhere on the board

Notes on the sheet:
40M (7Mhz) High Pass Filter

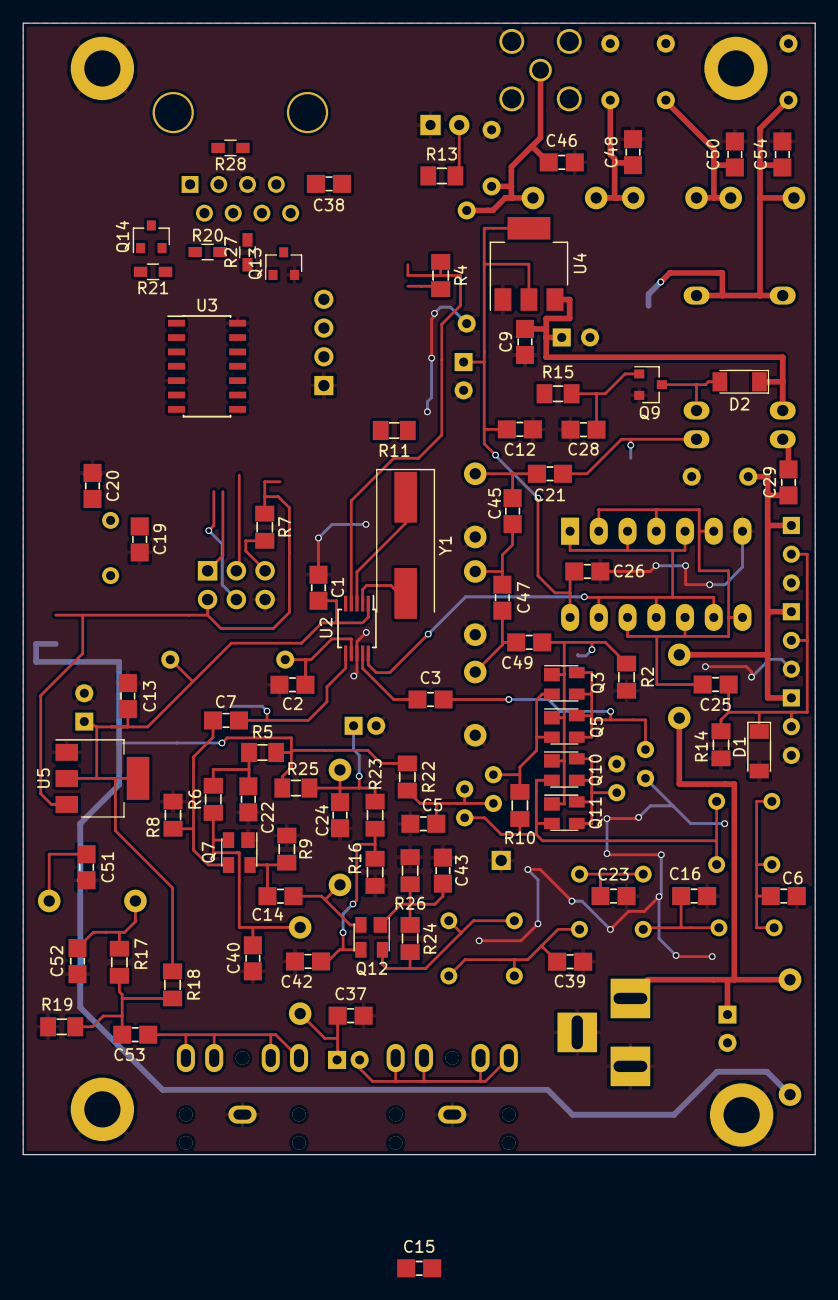
[picture p10: board PCBs_OpA/LCSDR.kicad_pcb from above]

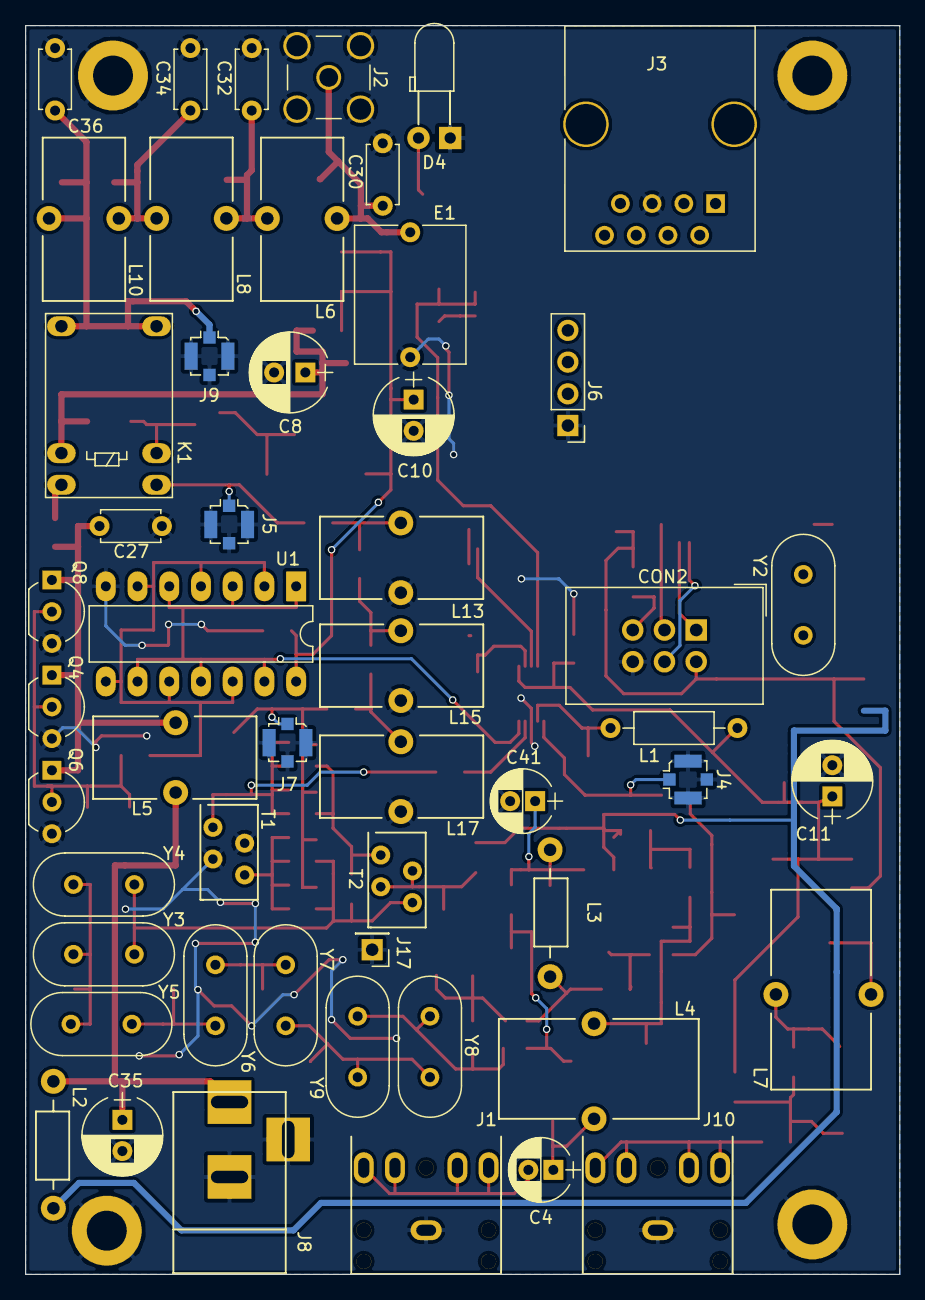
[picture p11: board PCBs_OpA/LCSDR.kicad_pcb from below]

Board: 2 copper layers, 70.0 x 100.0 mm, 135 parts (52 on the bottom side), 65 nets.
