arsenal007/ADX/PCBs/LCSDR.kicad_pcb

## KiCad design PCBs/LCSDR.kicad_pcb (2023-01-05)

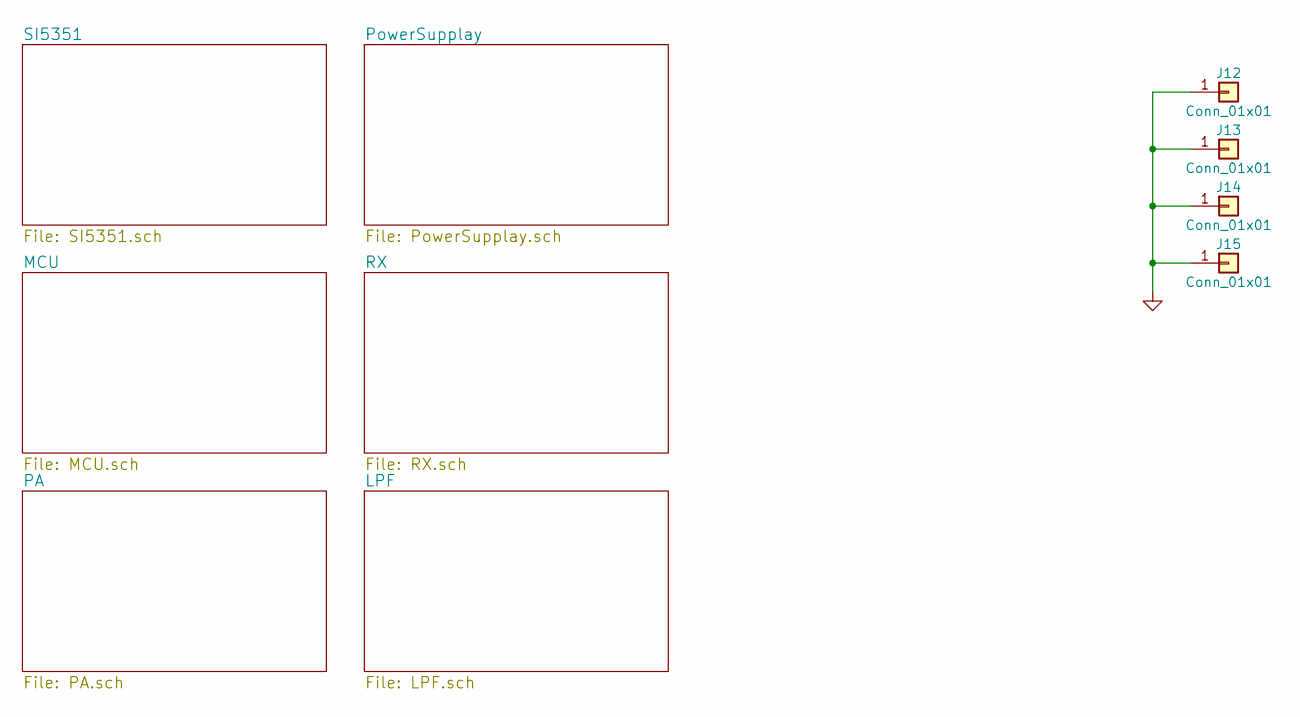
[picture p12: schematic LCSDR.sch, UT3MK VFO]

Parts:
J12, J13, J14, J15: Conn_01x01; MountingHole_3.2mm_M3_DIN965_Pad

Connections:
GND: J12.1, J13.1, J14.1, J15.1; also elsewhere on the board

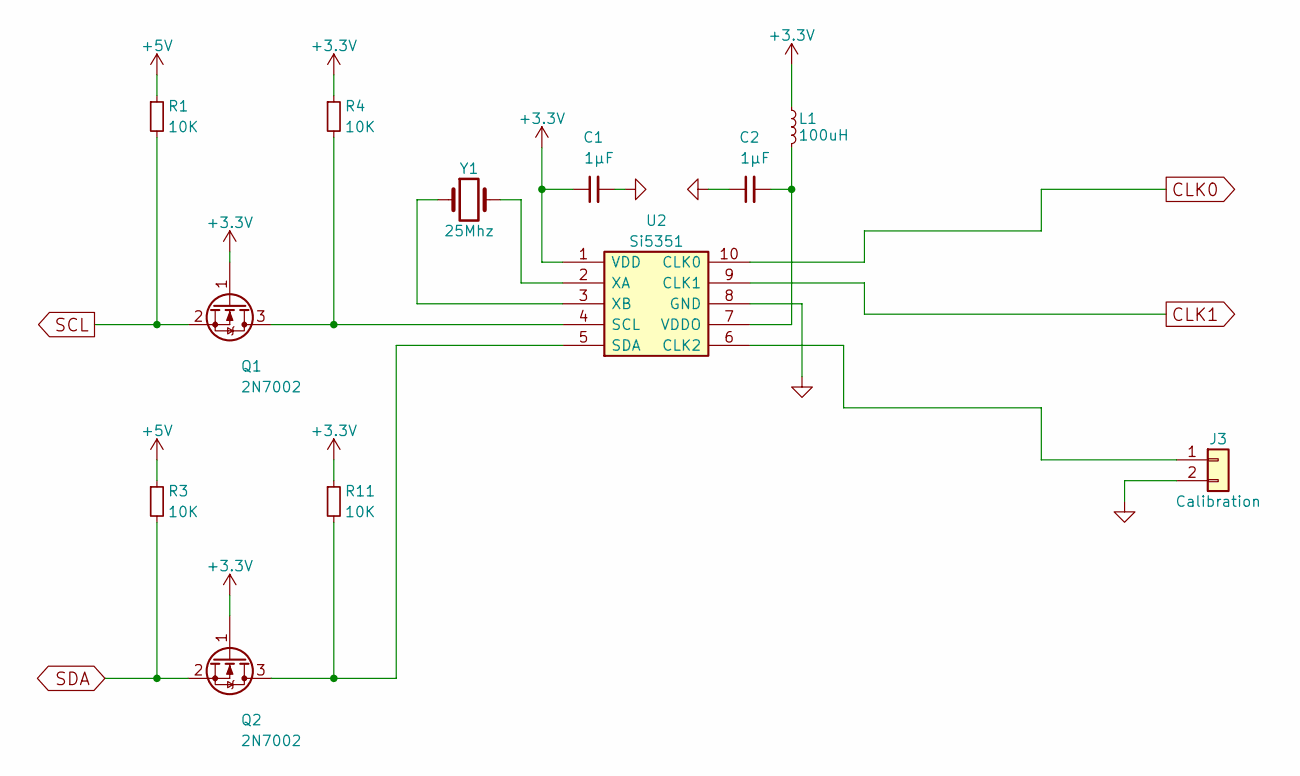
[picture p13: schematic SI5351.sch]

Parts:
C1, C2: 1µF; C_1206_0603
J3: Calibration; Pin_Header_Straight_1x02_Pitch2.54mm
L1: 100uH; Choke_Horizontal_RM10mm
Q1, Q2: 2N7002; SOT-23
R1, R3, R4, R11: 10K; R_0603_HandSoldering
U2: Si5351; MSOP-10_3x3mm_Pitch0.5mm
Y1: 25Mhz; Crystal_HC49-U_Vertical

Connections:
+3V3: C1.1, L1.1, Q1.1 (G), Q2.1 (G), R4.1, R11.1, U2.1 (VDD); also elsewhere on the board
+5V: R1.1, R3.1; also elsewhere on the board
CLK0: U2.10 (CLK0); also elsewhere on the board
CLK1: U2.9 (CLK1); also elsewhere on the board
GND: C1.2, C2.1, J3.2, U2.8 (GND); also elsewhere on the board
unnamed: C2.2, L1.2, U2.7 (VDDO)
unnamed: J3.1, U2.6 (CLK2)
unnamed: Q1.3 (D), R4.2, U2.4 (SCL)
unnamed: Q2.3 (D), R11.2, U2.5 (SDA)
unnamed: U2.2 (XA), Y1.2
unnamed: U2.3 (XB), Y1.1
SCL: Q1.2 (S), R1.2; also elsewhere on the board
SDA: Q2.2 (S), R3.2; also elsewhere on the board

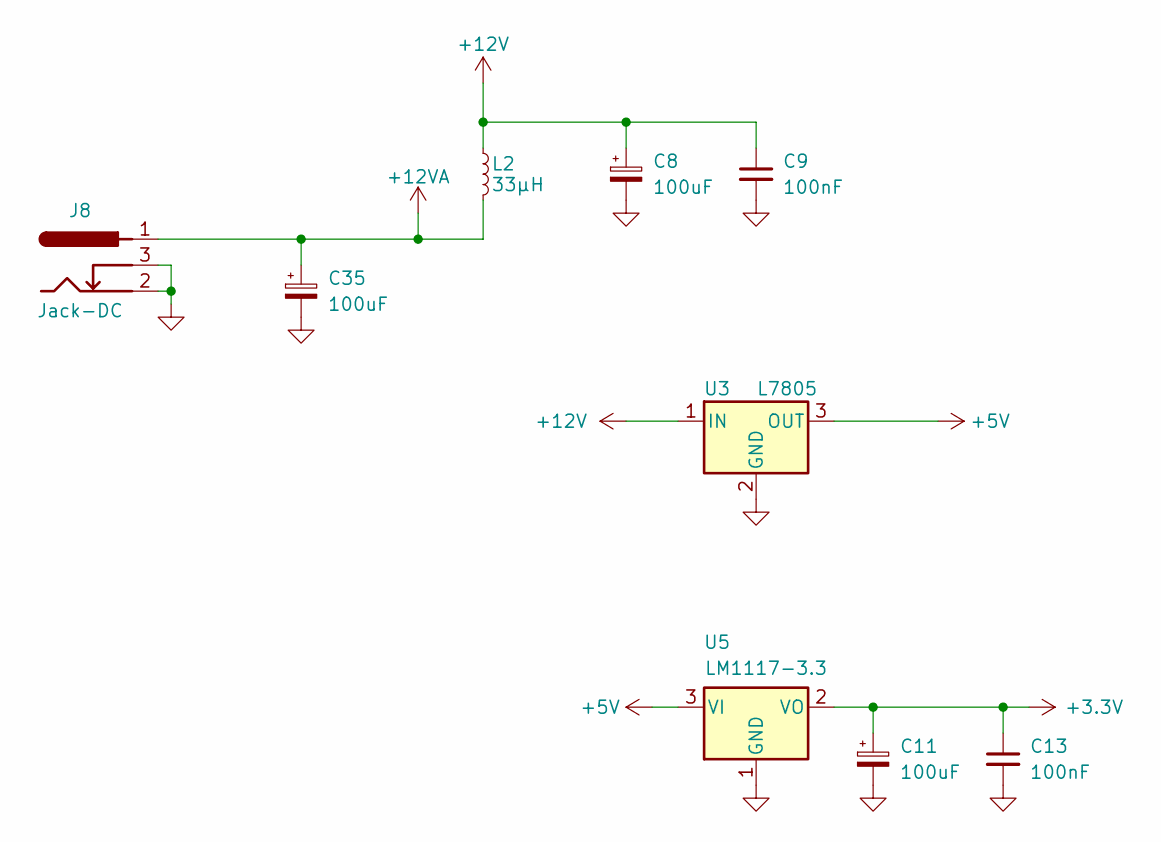
[picture p14: schematic PowerSupplay.sch]

Parts:
C8, C11, C35: 100uF; CP_Radial_D6.3mm_P2.50mm
C9, C13: 100nF; C_0603_HandSoldering
J8: Jack-DC; BARREL_JACK
L2: 33µH; Choke_Horizontal_RM10mm
U3: L7805; TO-220-3_Vertical
U5: LM1117-3.3; SOT-223-3_TabPin2

Connections:
+3V3: C11.1, C13.1, U5.2 (VO); also elsewhere on the board
+5V: U3.3 (OUT), U5.3 (VI); also elsewhere on the board
+12V: C8.1, C9.1, L2.1, U3.1 (IN); also elsewhere on the board
+12VA: C35.1, J8.1, L2.2; also elsewhere on the board
GND: C8.2, C9.2, C11.2, C13.2, C35.2, J8.2, J8.3, U3.2 (GND), U5.1 (GND); also elsewhere on the board
