arsenal007/ADX/PCBs/LCSDR.kicad_pcb

## KiCad design PCBs/LCSDR.kicad_pcb (continued)

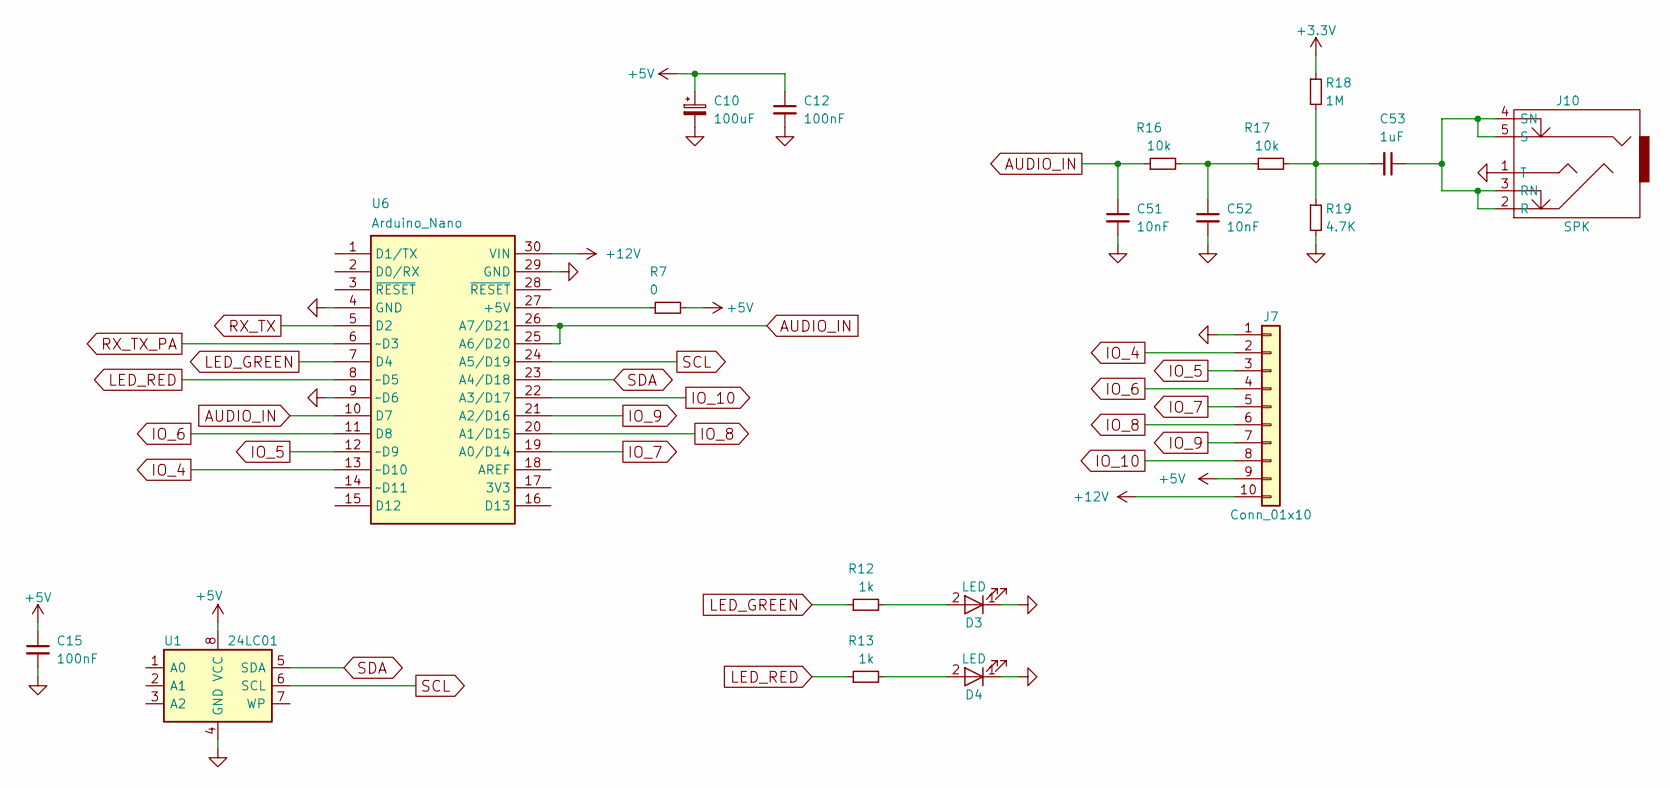
[picture p15: schematic MCU.sch]

Parts:
C10: 100uF; CP_Radial_D6.3mm_P2.50mm
C12, C15: 100nF; C_0603_HandSoldering
C51, C52: 10nF; C_0603_HandSoldering
C53: 1uF; C_0603_HandSoldering
D3, D4: LED; LED_0603_HandSoldering
J7: Conn_01x10; Pin_Header_Straight_1x10_Pitch2.54mm
J10: SPK; audio_jack_3_5mm_PJ307
R7: 0; R_0603_HandSoldering
R12, R13: 1k; R_0603_HandSoldering
R16, R17: 10k; R_0603_HandSoldering
R18: 1M; R_0603_HandSoldering
R19: 4.7K; R_0603_HandSoldering
U1: 24LC01; SOIC-8_3.9x4.9mm_Pitch1.27mm
U6: Arduino_Nano

Connections:
+3V3: R18.1; also elsewhere on the board
+5V: C10.1, C12.1, C15.1, J7.9, R7.2, U1.8 (VCC); also elsewhere on the board
+12V: J7.10, U6.30 (VIN); also elsewhere on the board
AUDIO_IN: C51.1, R16.1, U6.10 (D7), U6.25 (A6/D20), U6.26 (A7/D21)
GND: C10.2, C12.2, C15.2, C51.2, C52.2, D3.1 (K), D4.1 (K), J7.1, J10.1 (T), R19.2, U1.4 (GND), U6.4 (GND), U6.9 (~~D6), U6.29 (GND); also elsewhere on the board
IO_4: J7.2, U6.13 (~~D10)
IO_5: J7.3, U6.12 (~~D9)
IO_6: J7.4, U6.11 (D8)
IO_7: J7.5, U6.19 (A0/D14)
IO_8: J7.6, U6.20 (A1/D15)
IO_9: J7.7, U6.21 (A2/D16)
IO_10: J7.8, U6.22 (A3/D17)
LED_GREEN: R12.1, U6.7 (D4)
LED_RED: R13.1, U6.8 (~~D5)
unnamed: C52.1, R16.2, R17.1
unnamed: C53.1, J10.2 (R), J10.3 (RN), J10.4 (SN), J10.5 (S)
unnamed: C53.2, R17.2, R18.2, R19.1
unnamed: D3.2 (A), R12.2
unnamed: D4.2 (A), R13.2
unnamed: R7.1, U6.27 (+5V)
RX_TX: U6.5 (D2); also elsewhere on the board
RX_TX_PA: U6.6 (~~D3); also elsewhere on the board
SCL: U1.6 (SCL), U6.24 (A5/D19); also elsewhere on the board
SDA: U1.5 (SDA), U6.23 (A4/D18); also elsewhere on the board

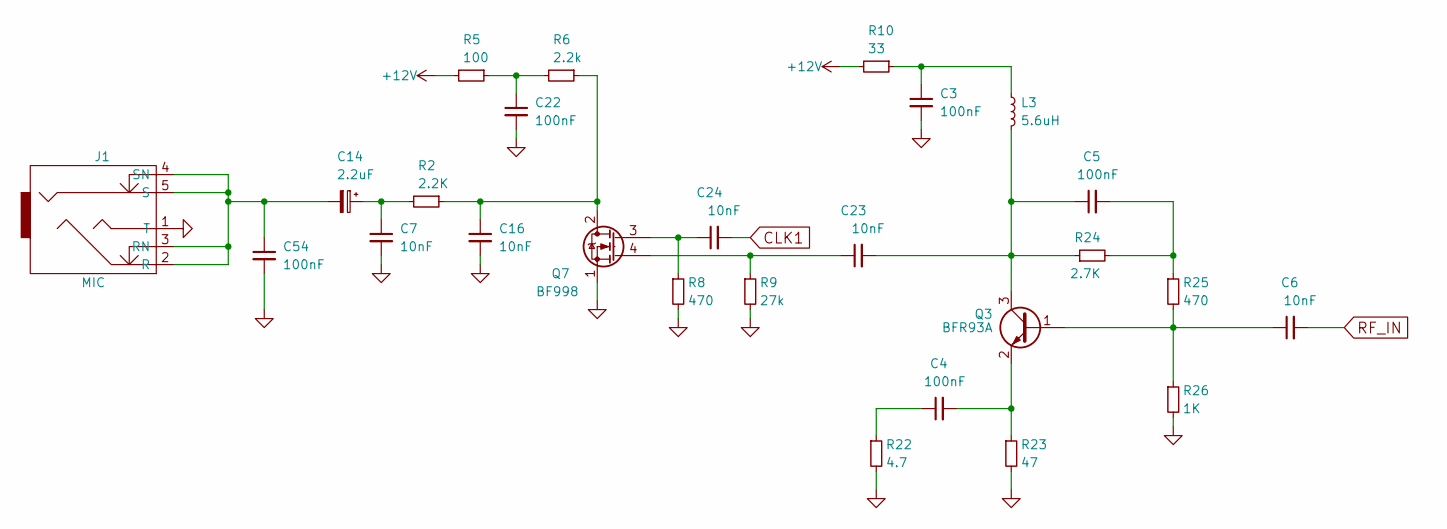
[picture p16: schematic RX.sch]

Parts:
C3, C4, C5, C22, C54: 100nF; C_0603_HandSoldering
C6, C7, C16, C23, C24: 10nF; C_0603_HandSoldering
C14: 2.2uF; CP_Radial_D5.0mm_P2.00mm
J1: MIC; audio_jack_3_5mm_PJ307
L3: 5.6uH; Choke_Horizontal_RM10mm
Q3: BFR93A; SOT-23
Q7: BF998; SOT-143
R2: 2.2K; R_1206_0603
R5: 100; R_1206_0603
R6: 2.2k; R_1206_0603
R8, R25: 470; R_1206_0603
R9: 27k; R_1206_0603
R10: 33; R_1206_0603
R22: 4.7; R_1206_0603
R23: 47; R_1206_0603
R24: 2.7K; R_1206_0603
R26: 1K; R_1206_0603

Connections:
+12V: R5.2, R10.2; also elsewhere on the board
CLK1: C24.2; also elsewhere on the board
GND: C3.2, C7.2, C16.2, C22.2, C54.2, J1.1 (T), Q7.1 (S), R8.2, R9.2, R22.2, R23.2, R26.2; also elsewhere on the board
unnamed: C3.1, L3.1, R10.1
unnamed: C4.1, R22.1
unnamed: C4.2, Q3.2 (E), R23.1
unnamed: C5.2, R24.2, R25.1
unnamed: C6.1, Q3.1 (B), R25.2, R26.1
unnamed: C7.1, C14.1, R2.2
unnamed: C14.2, C54.1, J1.2 (R), J1.3 (RN), J1.4 (SN), J1.5 (S)
unnamed: C16.1, Q7.2 (D), R2.1, R6.1
unnamed: C22.1, R5.1, R6.2
unnamed: C23.1, Q7.4 (G1), R9.1
unnamed: C5.1, C23.2, L3.2, Q3.3 (C), R24.1
unnamed: C24.1, Q7.3 (G2), R8.1
RF_IN: C6.2; also elsewhere on the board

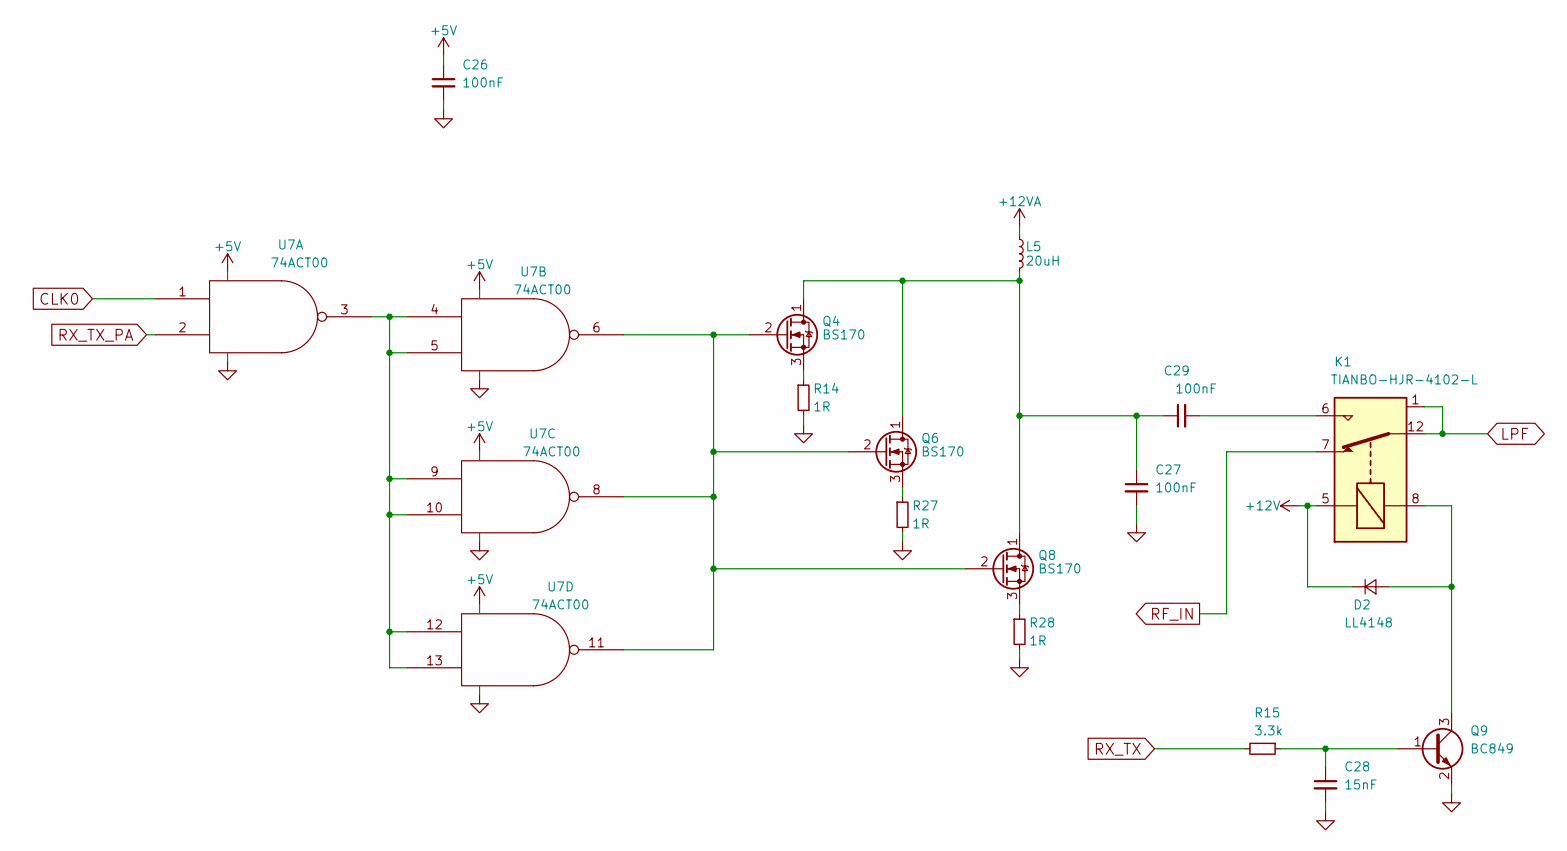
[picture p17: schematic PA.sch]

Parts:
C26, C27, C29: 100nF; C_0603_HandSoldering
C28: 15nF; C_0603_HandSoldering
D2: LL4148; D_MiniMELF
K1: TIANBO-HJR-4102-L; Relay_SPDT_HJR-4102
L5: 20uH; Choke_Toroid_6,5x13mm_Vertical
Q4, Q6, Q8: BS170; TO-92_Inline_Wide
Q9: BC849; SOT-23
R14, R27, R28: 1R; R_1206_0603
R15: 3.3k; R_0603_HandSoldering
U7: 74ACT00; SOIC-14_3.9x8.7mm_Pitch1.27mm

Connections:
+5V: C26.1, U7.14 (VCC); also elsewhere on the board
+12V: D2.1 (K), K1.5; also elsewhere on the board
+12VA: L5.1; also elsewhere on the board
CLK0: U7.1; also elsewhere on the board
GND: C26.2, C27.2, C28.2, Q9.2 (E), R14.2, R27.2, R28.2, U7.7 (GND); also elsewhere on the board
LPF: K1.1, K1.12; also elsewhere on the board
unnamed: C27.1, C29.1, L5.2, Q4.1 (D), Q6.1 (D), Q8.1 (D)
unnamed: C28.1, Q9.1 (B), R15.1
unnamed: C29.2, K1.6
unnamed: D2.2 (A), K1.8, Q9.3 (C)
unnamed: Q4.2 (G), Q6.2 (G), Q8.2 (G), U7.6, U7.8, U7.11
unnamed: Q4.3 (S), R14.1
unnamed: Q6.3 (S), R27.1
unnamed: Q8.3 (S), R28.1
unnamed: U7.3, U7.4, U7.5, U7.9, U7.10, U7.12, U7.13
RF_IN: K1.7; also elsewhere on the board
RX_TX: R15.2; also elsewhere on the board
RX_TX_PA: U7.2; also elsewhere on the board

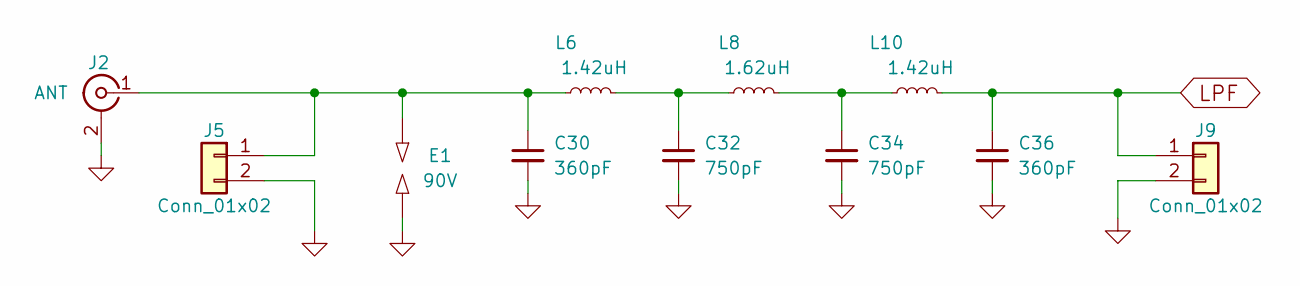
[picture p18: schematic LPF.sch]

Parts:
C30, C36: 360pF; C_0603_HandSoldering
C32, C34: 750pF; C_0603_HandSoldering
E1: 90V; C_Rect_L11.0mm_W8.8mm_P10.00mm_MKT
J2: ANT; SMA_THT_Jack_Straight
J5, J9: Conn_01x02; Pin_Header_Straight_1x02_Pitch2.54mm
L6, L10: 1.42uH; Choke_Toroid_5x10mm_Vertical
L8: 1.62uH; Choke_Toroid_5x10mm_Vertical

Connections:
GND: C30.2, C32.2, C34.2, C36.2, E1.2, J2.2 (Ext), J5.2, J9.2; also elsewhere on the board
LPF: C36.1, J9.1, L10.2; also elsewhere on the board
unnamed: C30.1, E1.1, J2.1 (In), J5.1, L6.1
unnamed: C32.1, L6.2, L8.1
unnamed: C34.1, L8.2, L10.1

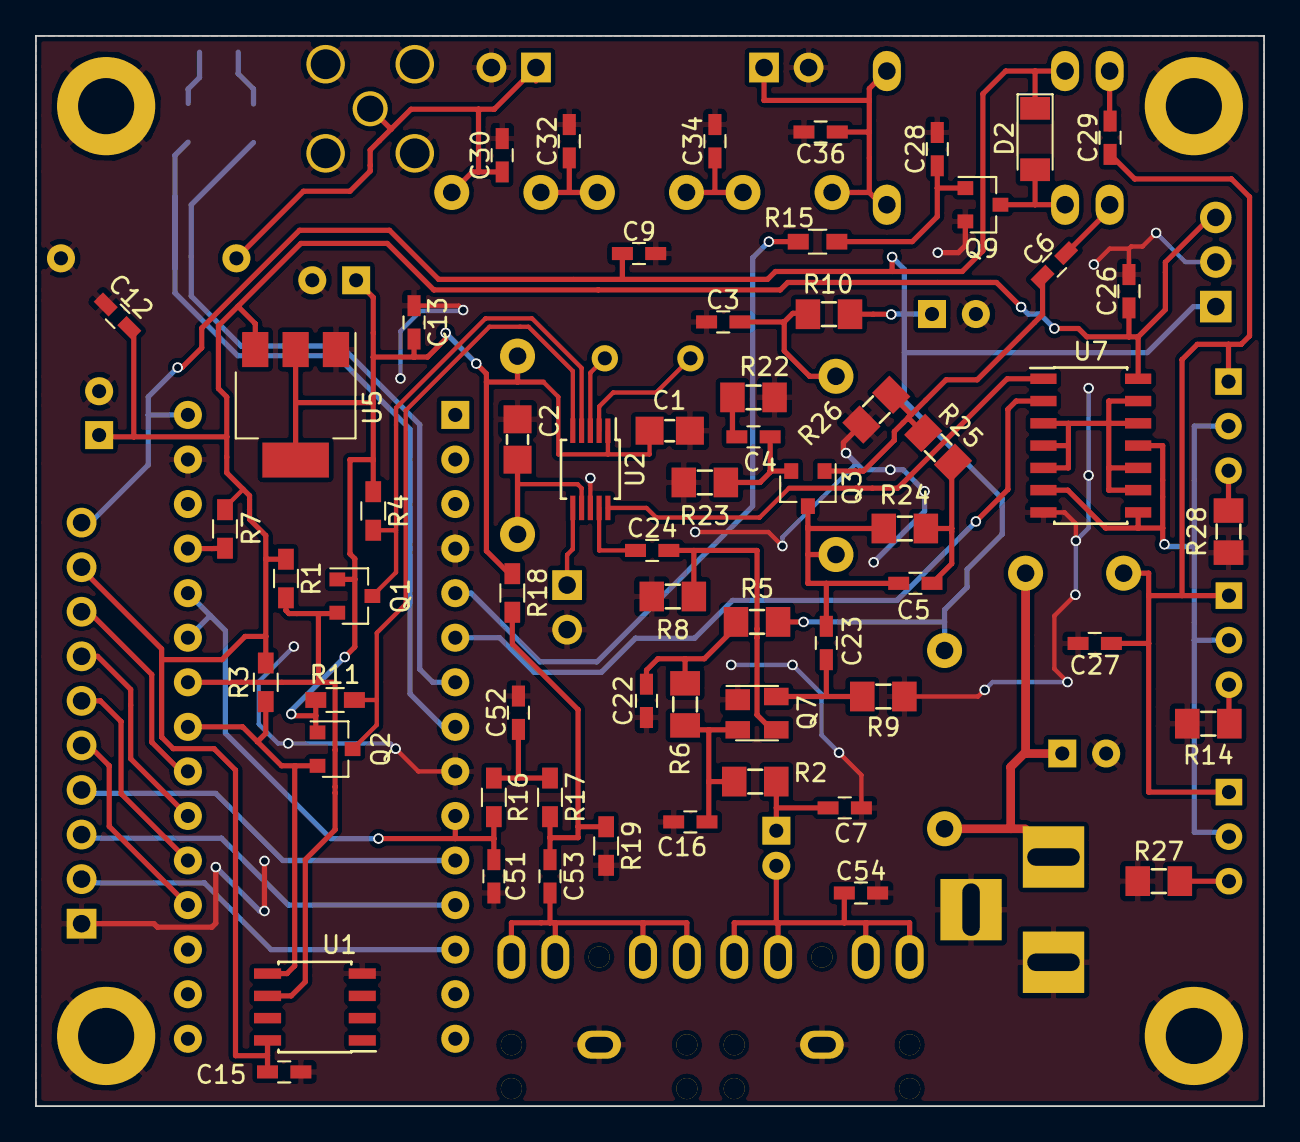
[picture p19: board PCBs/LCSDR.kicad_pcb from above]

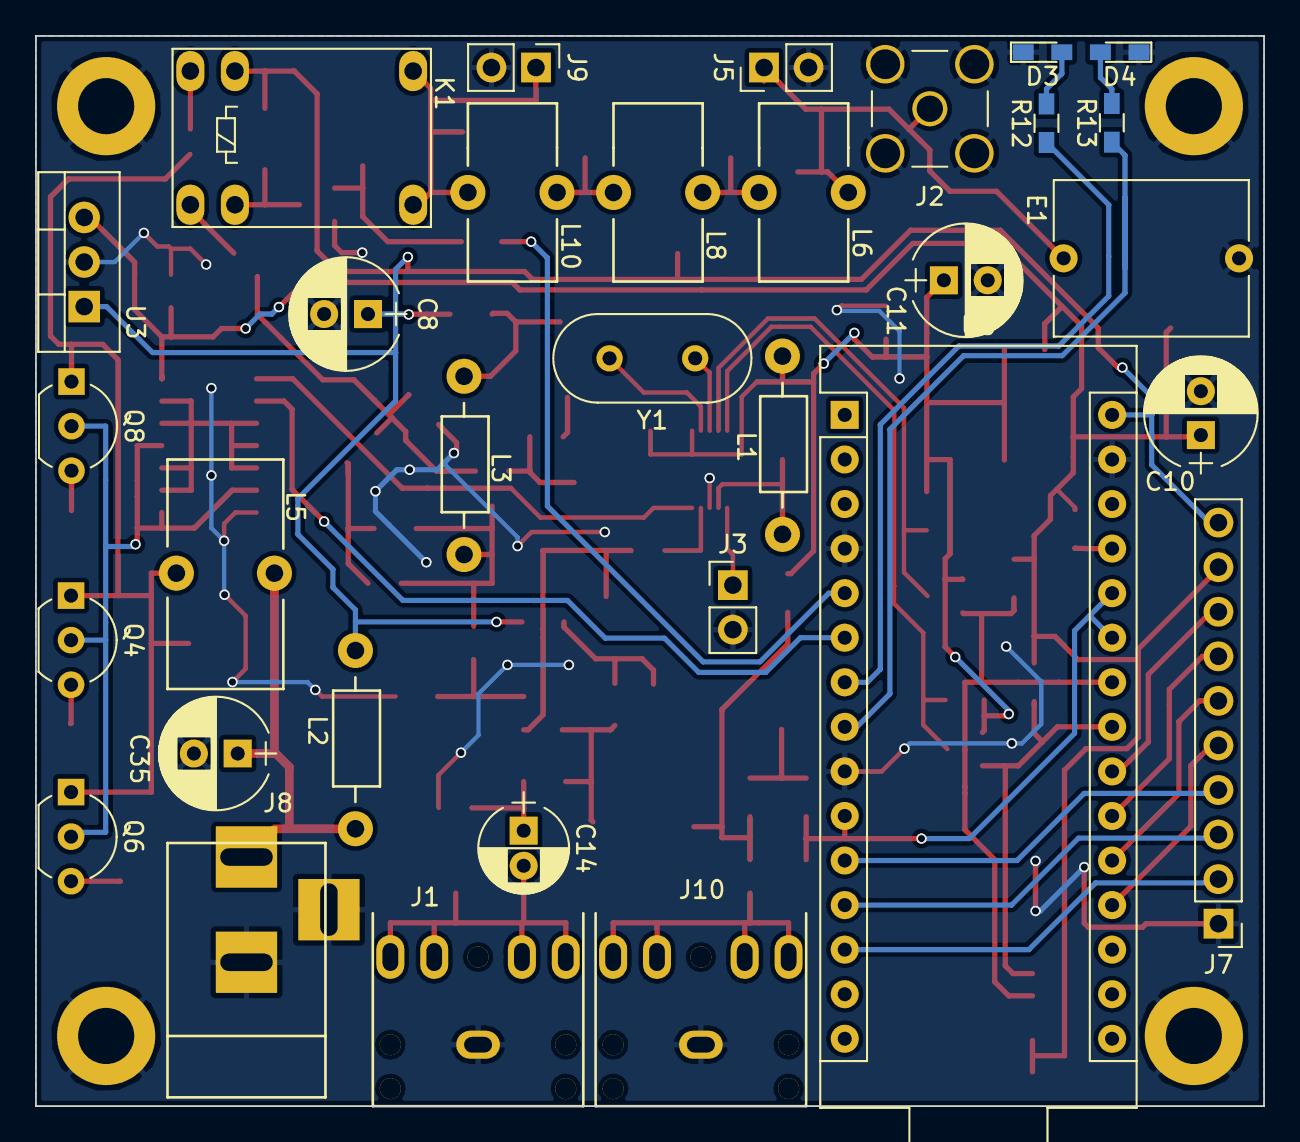
[picture p20: board PCBs/LCSDR.kicad_pcb from below]

Board: 2 copper layers, 70.0 x 61.0 mm, 97 parts (32 on the bottom side), 59 nets.
