arsenal007/ADX/PCB/LCSDR.kicad_pcb

## KiCad design PCB/LCSDR.kicad_pcb (2022-08-31)

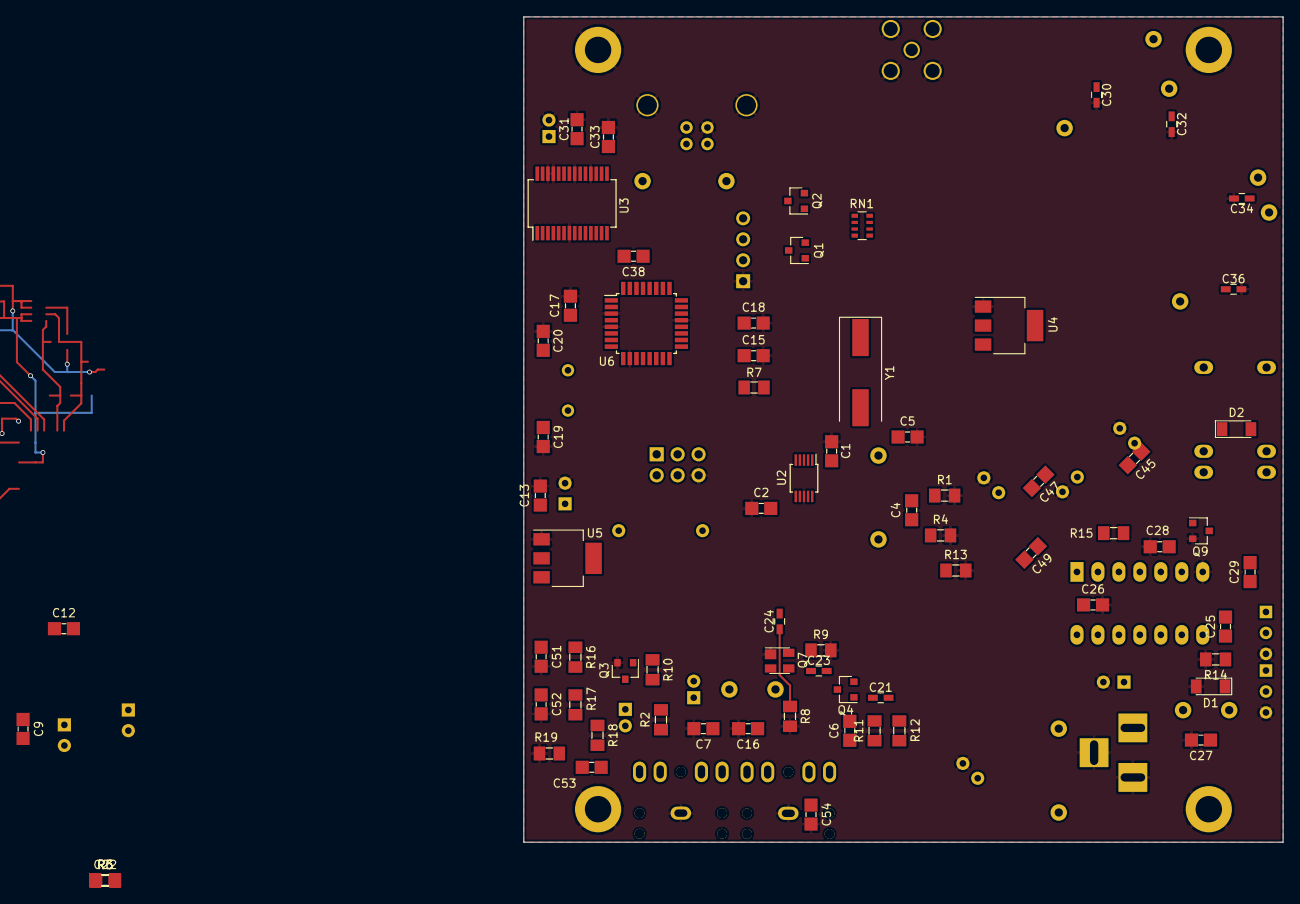
[picture p21: board PCB/LCSDR.kicad_pcb from above]

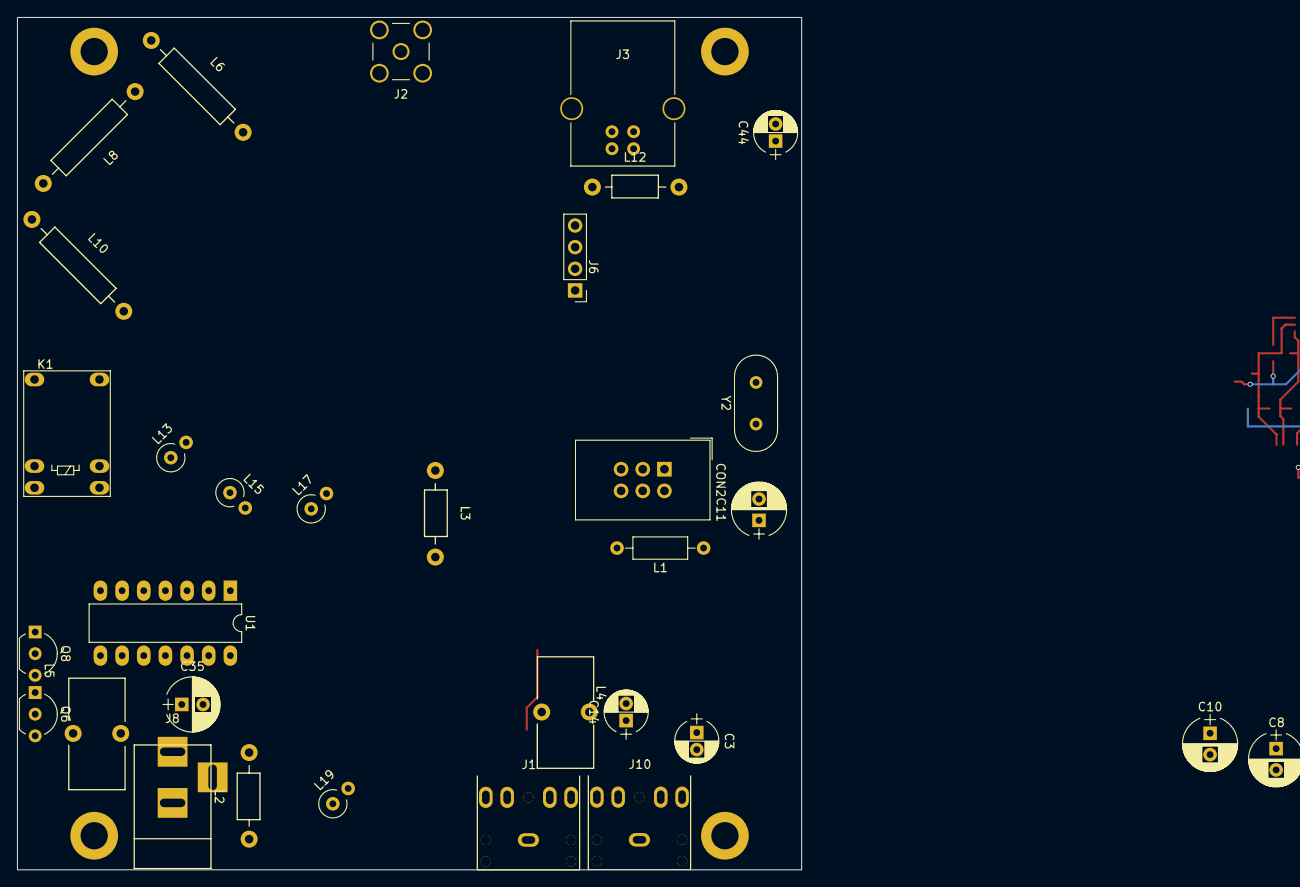
[picture p22: board PCB/LCSDR.kicad_pcb from below]

Board: 2 copper layers, 92.0 x 100.0 mm, 108 parts (32 on the bottom side), 61 nets.

Parts:
C1, C2: 1µF; C_1206_0603
C3, C14: 2.2uF; CP_Radial_D5.0mm_P2.00mm
C4, C5, C6, C7, C9, C12, C13, C15, C16, C17, C18, C22, C25, C26, C29, C31, C33, C38, C53, C54: 100nF; C_1206_0603
C8, C10, C11, C35: 100uF; CP_Radial_D6.3mm_P2.50mm
C19, C20: 22pF; C_1206_0603
C21, C23, C24: 10nF; C_0603_HandSoldering
C27, C28: 100pF; C_1206_0603
C30, C36: 270pF; C_0603_HandSoldering
C32, C34: 680pF; C_0603_HandSoldering
C44: 10uF; CP_Radial_D5.0mm_P2.00mm
C45, C49: 330pF; C_1206_0603
C47: 220pF; C_1206_0603
C51, C52: 10nF; C_1206_0603
CON2: AVR-ISP-6; IDC-Header_2x03_Pitch2.54mm_Straight
D1, D2: LL4148; D_MiniMELF
J1: MIC; audio_jack_3_5mm_PJ307
J2: ANT; SMA_THT_Jack_Straight
J3: USB_B
J6: I2C; Pin_Header_Straight_1x04_Pitch2.54mm
J8: Jack-DC; BARREL_JACK
J10: SPK; audio_jack_3_5mm_PJ307
J12, J13, J14, J15: Conn_01x01; MountingHole_3.2mm_M3_DIN965_Pad
K1: TIANBO-HJR-4102-L; Relay_SPDT_HJR-4102
L1: 100uH; R_Axial_DIN0207_L6.3mm_D2.5mm_P10.16mm_Horizontal
L2: 33µH; Choke_Horizontal_RM10mm
L3: 4.7uH; Choke_Horizontal_RM10mm
L4: 100mH; Choke_Toroid_6,5x13mm_Vertical
L5: 20uH; Choke_Toroid_6,5x13mm_Vertical
L6, L10: 1.32uH; Choke_Horizontal_RM15mm
L8: 1.72uH; Choke_Horizontal_RM15mm
L12: 10uH; Choke_Horizontal_RM10mm
L13, L19: 1uH; R_Axial_DIN0309_L9.0mm_D3.2mm_P2.54mm_Vertical
L15, L17: 680nH; R_Axial_DIN0309_L9.0mm_D3.2mm_P2.54mm_Vertical
Q1, Q2: 2N7002; SOT-23
Q3: BC847; SOT-23
Q4: BFR93A; SOT-23
Q6, Q8: BS170; TO-92_Inline_Wide
Q7: BF998; SOT-143
Q9: BC849; SOT-23
R1: 4R7; R_1206_0603
R2: 3.9K; R_1206_0603
R3, R5: 100; R_1206_0603
R4: 47R; R_1206_0603
R6: 2.2k; R_1206_0603
R7, R16, R17: 10k; R_1206_0603
R8, R12: 470; R_1206_0603
R9: 27k; R_1206_0603
R10: 470k; R_1206_0603
R11: 2.7k; R_1206_0603
R13: 1k; R_1206_0603
R14: 2.7K; R_1206_0603
R15: 3.3k; R_1206_0603
R18: 1M; R_1206_0603
R19: 4.7K; R_1206_0603
RN1: 10k; R_Array_Convex_4x0603
U1: 74AC14; DIP-14_W7.62mm_LongPads
U2: Si5351; MSOP-10_3x3mm_Pitch0.5mm
U3: FT232RL; SSOP-28_5.3x10.2mm_Pitch0.65mm
U4: LM1117-5.0; SOT-223-3_TabPin2
U5: LM1117-3.3; SOT-223-3_TabPin2
U6: ATMEGA328P-AU; TQFP-32_7x7mm_Pitch0.8mm
Y1: 25Mhz; Crystal_SMD_HC49-SD
Y2: 20Mhz; Crystal_HC49-U_Vertical

Connections:
+3V3: C1.1, C11.1, C13.1, L1.1, Q1.1, Q2.1, R18.1, RN1.5, RN1.6, U2.1, U5.2
+5V: C10.1, C12.1, C15.1, C17.1, C26.1, CON2.2, J6.2, L12.1, R7.1, RN1.7, RN1.8, U1.14, U4.2, U5.3, U6.4, U6.6, U6.18
+12V: C8.1, C9.1, D2.1, K1.8, L2.1, R2.1, R3.2, R5.2, U4.3
+12VA: C35.1, J8.1, L2.2, L5.1
CLK1: C24.2, U2.9
CLK2: U1.1, U1.3, U1.5, U1.9, U1.11, U1.13, U2.6
GND: C1.2, C2.1, C5.2, C7.2, C8.2, C9.2, C10.2, C11.2, C12.2, C13.2, C15.2, C16.2, C17.2, C18.2, C19.2, C20.2, C22.2, C26.2, C27.2, C28.2, C30.2, C31.2, C32.2, C33.2, C34.2, C35.2, C36.2, C44.2, C51.2, C52.2, C54.2, CON2.6, D1.2, J1.1, J2.2, J3.4, J3.5, J6.1, J8.2, J8.3, J10.1, J12.1, J13.1, J14.1, J15.1, L13.2, L15.2, L17.2, L19.2, Q3.2, Q6.3, Q7.1, Q8.3, Q9.2, R1.2, R4.2, R8.2, R9.2, R13.2, R14.2, R19.2, U1.7, U2.8, U3.7, U3.18, U3.21, U3.25, U3.26, U4.1, U5.1, U6.3, U6.5, U6.10, U6.21
IO_5: U6.1, U6.2
LPF: C36.1, K1.1, K1.12, L10.2
unnamed: C2.2, L1.2, U2.7
unnamed: C3.1, Q3.3, R2.2, R10.2
unnamed: C3.2, C54.1, J1.2, J1.3, J1.4, J1.5
unnamed: C4.1, Q4.2, R4.1
unnamed: C4.2, R1.1
unnamed: C5.1, L3.1, R3.1
unnamed: C6.1, R11.1, R12.1
unnamed: C7.1, C14.1, L4.1
unnamed: C14.2, Q3.1, R10.1
unnamed: C16.1, L4.2, Q7.2, R6.1
unnamed: C18.1, U6.20
unnamed: C19.1, U6.8, Y2.1
unnamed: C20.1, U6.7, Y2.2
unnamed: C21.1, Q4.1, R12.2, R13.1
unnamed: C22.1, R5.1, R6.2
unnamed: C23.1, Q7.4, R9.1
unnamed: C24.1, Q7.3, R8.1
unnamed: C25.1, U1.2, U1.4, U1.6, U1.8, U1.10, U1.12
unnamed: C25.2, D1.1, Q6.2, Q8.2, R14.1
unnamed: C27.1, C29.1, L5.2, Q6.1, Q8.1
unnamed: C28.1, Q9.1, R15.1
unnamed: C29.2, K1.6
unnamed: C30.1, J2.1, L6.1
unnamed: C31.1, C44.1, L12.2, U3.4, U3.19, U3.20
unnamed: C32.1, L6.2, L8.1
unnamed: C33.1, U3.17
unnamed: C34.1, L8.2, L10.1
unnamed: C38.2, U3.2
unnamed: C45.2, C47.1, L15.1
unnamed: C47.2, C49.1, L17.1
unnamed: C51.1, R16.1, U6.11
unnamed: C52.1, R16.2, R17.1
unnamed: C53.1, J10.2, J10.3, J10.4, J10.5
unnamed: C53.2, R17.2, R18.2, R19.1
unnamed: CON2.1, U6.16
unnamed: CON2.3, U6.17
unnamed: CON2.4, U6.15
unnamed: D2.2, K1.5, Q9.3
unnamed: J3.2, U3.15
unnamed: J3.3, U3.16
unnamed: Q1.2, RN1.4, U2.5
unnamed: Q2.2, RN1.3, U2.4
unnamed: U2.2, Y1.2
unnamed: U2.3, Y1.1
PREAMP_IN: C21.2, C49.2, L19.1
PREAMP_OUT: C6.2, C23.2, L3.2, Q4.3, R11.2
RESET: C38.1, CON2.5, R7.2, U6.29
RF_IN: C45.1, K1.7, L13.1
RxD: U3.1, U6.30
SCL: J6.4, Q2.3, RN1.1, U6.28
SDA: J6.3, Q1.3, RN1.2, U6.27
TxD: U3.5, U6.31
