arsenal007/ADX/Arduino_Sketch/ADX998/ADX988/ADX988.ino

//*********************************************************************************************************
//********************* ADX - ARDUINO based DIGITAL MODES 4 BAND HF TRANSCEIVER ***************************
//********************************* Write up start: 02/01/2022 ********************************************
// FW VERSION: ADX_QUAD_V1.1 - Version release date: 04/11/2022
// Barb (Barbaros ASUROGLU) - WB2CBA - 2022
//*********************************************************************************************************
// Required Libraries
// ----------------------------------------------------------------------------------------------------------------------
// Etherkit Si5351 (Needs to be installed via Library Manager to arduino ide) - SI5351 Library by Jason Mildrum (NT7S) - https://github.com/etherkit/Si5351Arduino
// Arduino "Wire.h" I2C library(built-into arduino ide)
// Arduino "EEPROM.h" EEPROM Library(built-into arduino ide)
//*************************************[ LICENCE and CREDITS ]*********************************************
//  FSK TX Signal Generation code by: Burkhard Kainka(DK7JD) - http://elektronik-labor.de/HF/SDRtxFSK2.html
//  SI5351 Library by Jason Mildrum (NT7S) - https://github.com/etherkit/Si5351Arduino

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
//*****************[ SI5351 VFO CALIBRATION PROCEDURE ]****************************************
// For SI5351 VFO Calibration Procedure follow these steps:
// 1 - Connect CAL test point and GND test point on ADX PCB to a Frequency meter or Scope that can measure 1 Mhz up to 1Hz accurately.
// 2 - Press SW2 / --->(CAL) pushbutton and hold.
// 4-  Power up with 12V or with 5V by using arduino USB socket while still pressing SW2 / --->(CAL) pushbutton.
// 5 - FT8 and WSPR LEDs will flash 3 times and stay lit. Now Release SW2 / --->(CAL). Now Calibration mode is active.
// 6 - Using SW1(<---) and SW2(--->) pushbuttons change the Calibration frequency.
// 7 - Try to read 1 Mhz = 1000000 Hz exact on  Frequency counter or Oscilloscope.
//     The waveform is Square wave so freqency calculation can be performed esaily.
// 7 - If you read as accurate as possible 1000000 Hz then calibration is done.
// 8 - Power off ADX.

//*******************************[ LIBRARIES ]*************************************************

#include "Wire.h"
#include <EEPROM.h>
#include "avr/wdt.h"
// Project includes
#include "CAT.hpp"
#include "VFO_BFO.hpp"
#include "leds.h"

//*******************************[ VARIABLE DECLERATIONS ]*************************************
uint32_t val;
int temp;
uint32_t val_EE;
int addr = 0;
int mode;
unsigned long freq;
unsigned long freq1;
int32_t cal_factor;
int TX_State = 0;

unsigned long F_FT8;
unsigned long F_FT4;
unsigned long F_JS8;
unsigned long F_WSPR;
int Band_slot;
int Band = 0;
int UP_State;
int DOWN_State;
int TXSW_State;
int Bdly = 250;
// **********************************[ DEFINE's ]***********************************************
#define UP 2    // UP Switch
#define DOWN 3  // DOWN Switch
#define TXSW 4  // TX Switch

#define TX 13 //TX LED
#define WSPR  9 //WSPR LED 
#define JS8  10 //JS8 LED
#define FT4  11 //FT4 LED
#define FT8 12 //FT8 LED

#define RX  14 // RX SWITCH
// #define SI5351_REF 		25000000UL  //change this to the frequency of the crystal on your si5351’s PCB, usually 25 or 27 MHz

//**********************************[ BAND SELECT ]************************************************
// ADX can support up to 4 bands on board. Those 4 bands needs to be assigned to Band1 ... Band4 from supported 6 bands.
// To change bands press SW1 and SW2 simultaneously. Band LED will flash 3 times briefly and stay lit for the stored band. also TX LED will be lit to indicate
// that Band select mode is active. Now change band bank by pressing SW1(<---) or SW2(--->). When desired band bank is selected press TX button briefly to exit band select mode.
// Now the new selected band bank will flash 3 times and then stored mode LED will be lit.
// TX won't activate when changing bands so don't worry on pressing TX button when changing bands in band mode.

// Assign your prefered bands to B1,B2,B3 and B4
// Supported Bands are: 80m, 40m, 30m, 20m,17m, 15m

#define VERSION 1

//*************************************[ SETUP FUNCTION ]**************************************
void setup()
{
  {
    MCUSR = 0;
    wdt_disable();
  }
  Serial.begin(57600);
  Serial.print("ADX988 ver. ");
  Serial.print(VERSION);
  Serial.print(";");

  // pinMode(UP, INPUT);
  // pinMode(DOWN, INPUT);
  // pinMode(TXSW, INPUT);

  // pinMode(TX, OUTPUT);
  // pinMode(WSPR, OUTPUT);
  // pinMode(JS8, OUTPUT);
  // pinMode(FT4, OUTPUT);
  // pinMode(FT8, OUTPUT);
  // pinMode(RX, OUTPUT);

  pinMode(7, INPUT); //PD7 = AN1 = HiZ, PD6 = AN0 = 0

  // INIT();

  //------------------------------- SET SI5351 VFO -----------------------------------
  // The crystal load value needs to match in order to have an accurate calibration
  vfo_init();
  /*si5351.init(SI5351_CRYSTAL_LOAD_8PF, 0, 0);
    si5351.set_correction(cal_factor, SI5351_PLL_INPUT_XO);
    si5351.set_pll(SI5351_PLL_FIXED, SI5351_PLLA);
    si5351.drive_strength(SI5351_CLK0, SI5351_DRIVE_8MA);// SET For Max Power
    si5351.drive_strength(SI5351_CLK1, SI5351_DRIVE_2MA); // Set for reduced power for RX*/

  TCCR1A = 0x00;
  TCCR1B = 0x01; // Timer1 Timer 16 MHz
  TCCR1B = 0x81; // Timer1 Input Capture Noise Canceller
  ACSR |= (1 << ACIC); // Analog Comparator Capture Input


  pinMode(7, INPUT); //PD7 = AN1 = HiZ, PD6 = AN0 = 0
  digitalWrite(RX, LOW);
  // Mode_assign();
  LEDS::init();
  wdt_enable(WDTO_1S);
}

//**************************[ END OF SETUP FUNCTION ]************************

//***************************[ Main LOOP Function ]**************************
void loop()
{
  wdt_reset();
  CAT_recive_cmd();
  unsigned int d1, d2;
  int FSK = 10;
  int FSKtx = 0;
  while (FSK > 0) {
    TCNT1 = 0;
    while (ACSR & (1 << ACO)) {
      if (TCNT1 > 65000) {
        break;
      }
    }  while ((ACSR & (1 << ACO)) == 0) {
      if (TCNT1 > 65000) {
        break;
      }
    }
    TCNT1 = 0;
    while (ACSR & (1 << ACO)) {
      if (TCNT1 > 65000) {
        break;
      }
    }
    d1 = ICR1;
    while ((ACSR & (1 << ACO)) == 0) {
      if (TCNT1 > 65000) {
        break;
      }
    }
    while (ACSR & (1 << ACO)) {
      if (TCNT1 > 65000) {
        break;
      }
    }
    d2 = ICR1;
    if (TCNT1 < 65000) {
      unsigned long codefreq = 2000000000 / (d2 - d1);
      if (codefreq < 350000) {
        if (FSKtx == 0) {
          TX_State = 1;
          // digitalWrite(TX, HIGH);
          // digitalWrite(RX, LOW);

          // si5351.output_enable(SI5351_CLK1, 0);   //RX off
          // si5351.output_enable(SI5351_CLK0, 1);   // TX on
        }
        // si5351.set_freq((freq * 100 + codefreq), SI5351_CLK0);

        FSKtx = 1;
      }
    }
    else {
      FSK--;
    }
  }
  digitalWrite(TX, 0);

  // si5351.output_enable(SI5351_CLK0, 0);   //TX off
  // si5351.set_freq(freq * 100ULL, SI5351_CLK1);
  // si5351.output_enable(SI5351_CLK1, 1);   //RX on
  TX_State = 0;
  digitalWrite(RX, HIGH);
  FSKtx = 0;
}
//*********************[ END OF MAIN LOOP FUNCTION ]*************************

//********************************************************************************
//******************************** [ FUNCTIONS ] *********************************
//********************************************************************************


//************************************[ MODE Assign ]**********************************

void Mode_assign() {

  addr = 40;
  EEPROM.get(addr, mode);


  if ( mode == 1) {
    freq1 = F_WSPR;
    digitalWrite(WSPR, HIGH);
    digitalWrite(JS8, LOW);
    digitalWrite(FT4, LOW);
    digitalWrite(FT8, LOW);

  }

  if ( mode == 2) {
    freq1 = F_JS8;
    digitalWrite(WSPR, LOW);
    digitalWrite(JS8, HIGH);
    digitalWrite(FT4, LOW);
    digitalWrite(FT8, LOW);



  }

  if ( mode == 3) {
    freq1 = F_FT4;

    digitalWrite(WSPR, LOW);
    digitalWrite(JS8, LOW);
    digitalWrite(FT4, HIGH);
    digitalWrite(FT8, LOW);


  }
  if ( mode == 4) {
    freq1 = F_FT8;

    digitalWrite(WSPR, LOW);
    digitalWrite(JS8, LOW);
    digitalWrite(FT4, LOW);
    digitalWrite(FT8, HIGH);


  }
  freq = freq1;
  //freq = freq1 - 1000;

}

//********************************[ END OF MODE ASSIGN ]*******************************

//*********************[ Band dependent Frequency Assign Function ]********************
void Freq_assign() {


  //---------- 80m/3.5Mhz
  if (Band == 80) {

    F_FT8 = 3573000;
    F_FT4 = 3575000;
    F_JS8 = 3578000;
    F_WSPR = 3568600;
  }

  //---------- 40m/7 Mhz
  if (Band == 40) {

    F_FT8 = 7074000;
    F_FT4 = 7047500;
    F_JS8 = 7078000;
    F_WSPR = 7038600;
  }


  //---------- 30m/10 Mhz
  if (Band == 30) {

    F_FT8 = 10136000;
    F_FT4 = 10140000;
    F_JS8 = 10130000;
    F_WSPR = 10138700;
  }


  //---------- 20m/14 Mhz
  if (Band == 20) {

    F_FT8 = 14074000;
    F_FT4 = 14080000;
    F_JS8 = 14078000;
    F_WSPR = 14095600;
  }


  //---------- 17m/18 Mhz
  if (Band == 17) {

    F_FT8 = 18100000;
    F_FT4 = 18104000;
    F_JS8 = 18104000;
    F_WSPR = 18104600;
  }

  //---------- 15m/ 21Mhz
  if (Band == 15) {

    F_FT8 = 21074000;
    F_FT4 = 21140000;
    F_JS8 = 21078000;
    F_WSPR = 21094600;
  }

}
//************************[ End of Frequency assign function ]*************************

//******************************[ Band  Assign Function ]******************************

void Band_assign() {
  digitalWrite(WSPR, LOW);
  digitalWrite(JS8, LOW);
  digitalWrite(FT4, LOW);
  digitalWrite(FT8, LOW);


  addr = 50;
  EEPROM.get(addr, Band_slot);

  if (Band_slot == 1) {
    // Band = Band1;

    digitalWrite(WSPR, HIGH);
    delay(Bdly);
    digitalWrite(WSPR, LOW);
    delay(Bdly);
    digitalWrite(WSPR, HIGH);
    delay(Bdly);
    digitalWrite(WSPR, LOW);
    delay(Bdly);
    digitalWrite(WSPR, HIGH);
    delay(Bdly);
    digitalWrite(WSPR, LOW);
    delay(Bdly);
  }

  if (Band_slot == 2) {
    // Band = Band2;

    digitalWrite(JS8, HIGH);
    delay(Bdly);
    digitalWrite(JS8, LOW);
    delay(Bdly);
    digitalWrite(JS8, HIGH);
    delay(Bdly);
    digitalWrite(JS8, LOW);
    delay(Bdly);
    digitalWrite(JS8, HIGH);
    delay(Bdly);
    digitalWrite(JS8, LOW);
    delay(Bdly);
  }

  if (Band_slot == 3) {
    // Band = Band3;

    digitalWrite(FT4, HIGH);
    delay(Bdly);
    digitalWrite(FT4, LOW);
    delay(Bdly);
    digitalWrite(FT4, HIGH);
    delay(Bdly);
    digitalWrite(FT4, LOW);
    delay(Bdly);
    digitalWrite(FT4, HIGH);
    delay(Bdly);
    digitalWrite(FT4, LOW);
    delay(Bdly);
  }

  if (Band_slot == 4) {
    // Band = Band4;

    digitalWrite(FT8, HIGH);
    delay(Bdly);
    digitalWrite(FT8, LOW);
    delay(Bdly);
    digitalWrite(FT8, HIGH);
    delay(Bdly);
    digitalWrite(FT8, LOW);
    delay(Bdly);
    digitalWrite(FT8, HIGH);
    delay(Bdly);
    digitalWrite(FT8, LOW);
    delay(Bdly);
  }


  delay(1000);

  Freq_assign();

  Mode_assign();


}
//***************************[ End of Band assign function ]***************************


//*******************************[ Manual TX FUNCTION ]********************************
/*void ManualTX() {

  digitalWrite(RX, LOW);
  // si5351.output_enable(SI5351_CLK1, 0);   //RX off


  TXON:

  TXSW_State = digitalRead(TXSW);


  digitalWrite(TX, 1);
  // si5351.set_freq(freq1 * 100ULL, SI5351_CLK0);
  // si5351.output_enable(SI5351_CLK0, 1);   //TX on
  TX_State = 1;

  if (TXSW_State == HIGH) {
    goto EXIT_TX;

  }
  goto TXON;




  EXIT_TX:
  digitalWrite(TX, 0);
  si5351.output_enable(SI5351_CLK0, 0);   //TX off
  TX_State = 0;

  }*/

//********************************[ END OF Manual TX ]*********************************
