arsenal007/ADX/Arduino_Sketch/ADX998/INIT/INIT.ino

#include "leds.h"
#include "detector.h"
#include "CAT.h"
#include "VFO.h"
// watchdog
#include <WDT.h>
// Must include this to be able change the prescaler frequency
#include <avr/power.h>


#define VERSION 2

// 162010

void setup() {
  // This runs MCU at full speed. See comment below.
  clock_prescale_set(clock_div_1);
  {
    MCUSR &= ~(1<<WDRF); // Clear WDRF in MCUSR
    wdt_disable();
  }
  Serial.begin(57600);
  
  // the MCU Frequency is described in ~\Arduino Sketches\hardware\LGT\avr\boards.txt
  // on this line: lardu_328x.build.f_cpu=32000000L
  Serial.print("F_CPU value: "); 
  Serial.println(F_CPU);
  Serial.print("Clock cycles per µsecond: "); 
  Serial.println(clockCyclesPerMicrosecond());

  uint32_t guid = *(uint32_t*)&GUID0 ;
  Serial.print("GUID of this device: "); 
  Serial.println(guid, HEX);
  
  Serial.print("ADX988 INIT ver. ");
  Serial.print(VERSION);
  Serial.print("\n");
  ::DETECTOR::init();
  ::LEDS::init();
  ::VFO::init();
  Serial.println(F("R; // reboot"));
  Serial.println(F("RT; // Reset EEPROM setting to default values and reboot"));
  Serial.println(F("UCXXXXX; // Set Si5351A Crystal frequncy in kHz (Example: UC27000; for 27000kHz)"));
  Serial.println(F("UPXXX; // Set Si5351A PLL frequncy in MHz (Example: UP900; for 900Mhz)"));
  Serial.println(F("UK; // Save Correction and reboot"));
  Serial.println(F("   Up:    q   w   e   f   g   h   j"));
  Serial.println(F(" Down:    a   s   d   v   b   n   m"));
  Serial.println(F("   Hz:  0.01 0.1  1   10  100 1K  10k"));
  wdt_enable(WTO_1S);
  // wdt_enable(WTO_2S);
}

void loop() {
  // reset the WDT
  wdt_reset();
  CAT_recive_cmd();
  if (::DETECTOR::FREQ::valid()) {
    ::LEDS::tx();
    Serial.print("FREQUENCY: ");
    unsigned long detected_audio_frequency = ::DETECTOR::FREQ::get();
    Serial.print(detected_audio_frequency );
    Serial.print("\n");

  } else {
    ::LEDS::tx_over();
  }


}
