arsenal007/ADX/Arduino_Sketch/ADX998/INIT/VFO.cpp

// leds library

#include <Arduino.h>
#include <inttypes.h>
#include "VFO.h"
#include "si5351.h"
#include "Wire.h"





namespace {
unsigned long freq = 10000000;
Si5351 si5351{};
VFO::eeprom_data init_data_struct{};

const uint8_t addresses[] = {0x60, 0x6F};

void update(void) {
  //EEPROM.put(VFO_EEPROM_ADDRESS, ::init_data_struct);
  unsigned char* pData = (unsigned char*)&::init_data_struct;
  for (unsigned char i = 0; i < VFO_EEPROM_SIZE; i++) {
    Wire.beginTransmission(EEPROM_ADDRESS);
    Wire.write(VFO_EEPROM_ADDRESS + i); // The address to write to
    Wire.write(pData[i]); // The data to write, a random value between 0 and 255
    Wire.endTransmission();
    delay(10);
  }

  si5351.reset();
  // End I2C comms
  // Wire.end();
  delay(4000);
}

void init_s(void) {
  volatile unsigned long xo_freq = ::init_data_struct.crystal * 1000UL;  // kHz convert to Hz
  ::si5351.init(::init_data_struct.address, SI5351_CRYSTAL_LOAD_8PF, xo_freq, 0);
  ::si5351.set_correction(::init_data_struct.correction, SI5351_PLL_INPUT_XO);
  volatile unsigned long long pll = ::init_data_struct.pll * 100000000ULL;
  ::si5351.set_pll(pll, SI5351_PLLA);
  ::si5351.set_pll(pll, SI5351_PLLB);

  ::si5351.set_ms_source(SI5351_CLK1, SI5351_PLLB);
  ::si5351.set_ms_source(SI5351_CLK2, SI5351_PLLB);

  ::si5351.drive_strength(SI5351_CLK0, SI5351_DRIVE_8MA); // SET For Max Power
  ::si5351.drive_strength(SI5351_CLK1, SI5351_DRIVE_8MA); // Set for reduced power for RX/
  ::si5351.drive_strength(SI5351_CLK2, SI5351_DRIVE_8MA);

  ::si5351.output_enable(SI5351_CLK0, 0);
  ::si5351.output_enable(SI5351_CLK1, 1);
  ::si5351.output_enable(SI5351_CLK2, 1);
  unsigned long long f = ::init_data_struct.freqs[::init_data_struct.f_index] * 100ULL;
  ::si5351.set_freq(f, SI5351_CLK1);
  // ::si5351.update_status();
}
}
namespace VFO {
void save(void) {
  ::update();
}
namespace SET {
// Set up crystal frequency in kHz
void crystal( unsigned int v) {
  ::init_data_struct.crystal = v;
  ::update();
}

void clk2( unsigned long f ) {
  freq = f;
  ::si5351.set_freq(freq * 100ULL, SI5351_CLK2);
}

void pll( unsigned int v) {
  ::init_data_struct.pll = v;
  ::update();
}


void correction(volatile long c) {
  ::init_data_struct.correction += c;
  Serial.print("SI5351 Correction: ");
  Serial.print(::init_data_struct.correction);
  Serial.print("\n");
  ::init_s();
  ::si5351.set_freq(freq * 100ULL, SI5351_CLK2);
}
}

void eeprom_erase(void) {
  ::init_data_struct.address = 0xFF;
  ::init_data_struct.crystal = 25000U;
  ::init_data_struct.pll = 800;
  ::init_data_struct.correction = 0;
  ::init_data_struct.f_index = 0;
  ::init_data_struct.freqs[0] = 4995000UL;
  ::init_data_struct.freqs[1] = 4995000UL;

  ::update();
}



void init(void) {
  // read saved data from eeprom
  // EEPROM.get(VFO_EEPROM_ADDRESS, ::init_data_struct);
  unsigned char* pData = (unsigned char*)&::init_data_struct;
  Wire.beginTransmission( EEPROM_ADDRESS );
  Wire.write( VFO_EEPROM_ADDRESS );
  Wire.endTransmission();
  Wire.requestFrom( EEPROM_ADDRESS, VFO_EEPROM_SIZE );
  for (unsigned char i = 0; i < VFO_EEPROM_SIZE; i++) {
    pData[i] = Wire.read();
  }

  // check if current address is present
  bool present = false;
  for (unsigned char i = 0; i < sizeof(addresses); i++) {
    if (::init_data_struct.address == addresses[i]) {
      Serial.print("Saved SI5351 i2c address: ");
      Serial.print(::init_data_struct.address, HEX);
      Serial.print("\n");
      present = true;
      break;
    }
  }



  if (!present)
  { // scan i2c bus
    Wire.begin();
    Serial.print("Scaned SI5351 i2c address: ");
    for (uint8_t i = 0; i < sizeof(addresses); i++) {
      Wire.beginTransmission(addresses[i]);
      byte error = Wire.endTransmission();
      if (error == 0)  {
        present = true;
        ::init_data_struct.address = addresses[i];
        Serial.print(::init_data_struct.address, HEX);
        break;
      }
    }
    if (!present ) {
      Serial.print(" Not Found\n");
      return;
    }
    Serial.print("\n");
  }

  Serial.print("SI5351 Crystal Frequency: ");
  Serial.print(::init_data_struct.crystal);
  Serial.print("kHz \n");

  Serial.print("SI5351 PLL Frequency: ");
  Serial.print(::init_data_struct.pll);
  Serial.print("Mhz \n");

  Serial.print("SI5351 Correction: ");
  Serial.print(::init_data_struct.correction);
  Serial.print("\n");

  Serial.print("Defualt rx ch:");
  Serial.print(::init_data_struct.f_index);
  Serial.print("\n");
  Serial.print("Defualt rx frequncy:");
  Serial.print(::init_data_struct.freqs[::init_data_struct.f_index]);
  Serial.print("Hz\n");


  init_s();
}
}
