arsenal007/ADX/Arduino_Sketch/ADX998/ADX988/VFO_BFO.hpp

#pragma once



// SET DESIRED Frequency
void vfo_set_cal_frequency( unsigned long );

// REAL frequency
void vfo_set_cal_factor( long );



void vfo_init(void);

// set VFO frequency
void vfo( unsigned long f );
