arsenal007/ADX/(commit log)

2022-08-31 PCBs_Opa with axial inductace in HPF
    [ADX QUAD BOM.xlsx, ADX Serial resonance Band filter module component table.xlsx, ADX.kicad_pcb, ADX.sch, BPF.sch, BPF2.sch, BPF3.sch, HPF.sch]
2022-09-02 operational amplifier Direct detection receiver
    [HPF.sch, LCSDR.kicad_pcb, LPF.sch, RX998.sch]
2022-09-11 add LPF/HPF RFSimm models
    [HPF.sch, LCSDR.kicad_pcb, LPF.sch, MCU.sch, PA.sch, RS232.sch, RX998.sch, SI5351.sch]
2022-09-18 release gerber files
    [HPF.sch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]
2022-09-18 add text to HPF/LPF sch
    [HPF.sch, LCSDR.sch, LPF.sch, MCU.sch, PA.sch, PowerSupplay.sch, RS232.sch, RX998.sch]
2022-10-11 ADX988 CAT: add FE, FI commands
    [HPF.sch, Inverters.sch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]
2022-11-27 discret, simple, CH340E
    [LCSDR.kicad_pcb, LCSDR.sch, LPF.sch, MCU.sch, PA.sch, PowerSupplay.sch, RS232.sch, RX.sch]
2022-12-18 INIT project, si5351 generate properly frequency
    [LCSDR.kicad_pcb, LCSDR.sch, LPF.sch, MCU.sch, PA.sch, PowerSupplay.sch, RS232.sch, RX.sch]
2022-12-25 add printout, finish PCB, add LM7805
    [LCSDR.kicad_pcb, LCSDR.sch, LPF.sch, MCU.sch, PA.sch, PowerSupplay.sch, RX.sch, SI5351.sch]
2022-12-26 greber files
    [LCSDR-B.Cu.gbl, LCSDR-B.Mask.gbs, LCSDR-B.SilkS.gbo, LCSDR-Edge.Cuts.gm1, LCSDR-F.Cu.gtl, LCSDR-F.Mask.gts, LCSDR-F.SilkS.gto, LCSDR.drl]
2023-01-05 Arduino Nano PCB ADX988 DSP
    [HPF.sch, LCSDR.kicad_pcb, LCSDR.sch, LPF.sch, MCU.sch, PA.sch, PowerSupplay.sch, RS232.sch]
2023-01-30 Migrate to LGT8F328p
    [MCU.sch]
2023-01-31 try to fix detector
    [INIT.ino, detector.cpp, leds.cpp]
