arsenal007/ADX/(notices)

Notices in the files:
Arduino_Sketch/ADX998/INIT/si5351.h:
This program is free software: you can redistribute it and/or modify
it under the terms of the GNU General Public License as published by
the Free Software Foundation, either version 3 of the License, or
(at your option) any later version.
